Xerolux/IDM-Smart-Climate-Platform/hardware/esp-sensor/manufacturing/B-ES3-C6/IDM-RoomSensor-ESP-B-ES3-C6-top.png

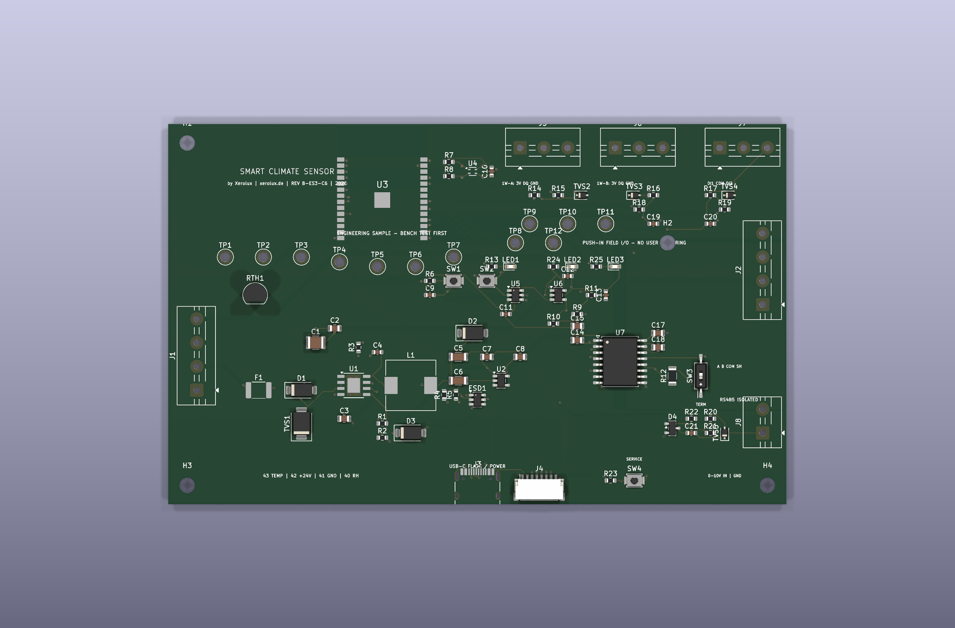
hardware/esp-sensor/manufacturing/B-ES3-C6/IDM-RoomSensor-ESP-B-ES3-C6-top.png
