Xerolux/IDM-Smart-Climate-Platform/hardware/classic-sensor/manufacturing/B-ES1/IDM-RoomSensor-Classic-B-ES1-top.png

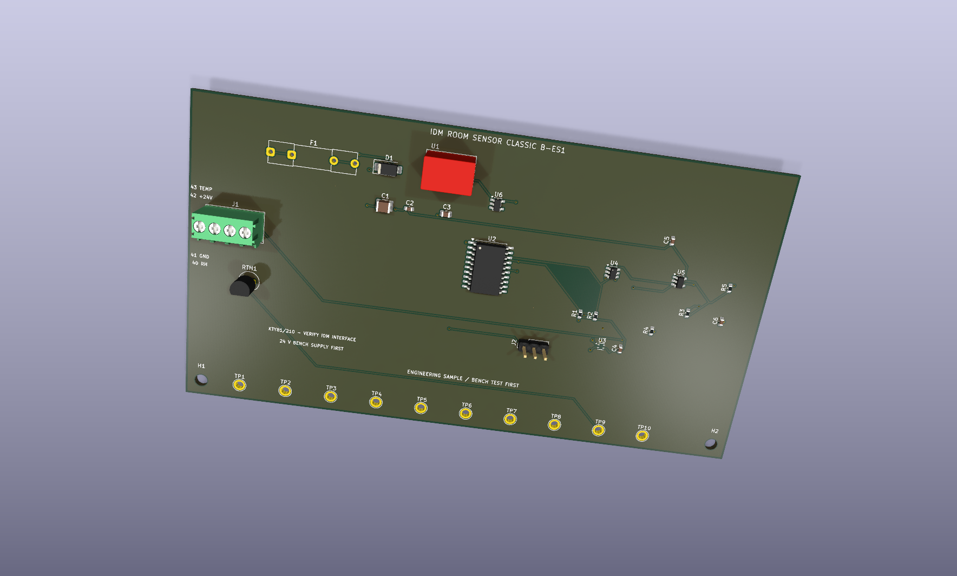
hardware/classic-sensor/manufacturing/B-ES1/IDM-RoomSensor-Classic-B-ES1-top.png
