Xerolux/IDM-Smart-Climate-Platform/hardware/esp-sensor/enclosure/idm-roomsensor-b-es3-c6-preview.png

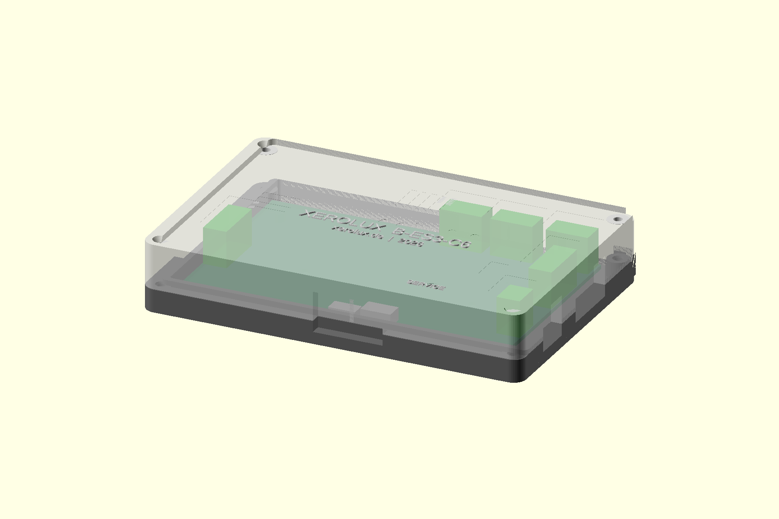
hardware/esp-sensor/enclosure/idm-roomsensor-b-es3-c6-preview.png
