Xerolux/IDM-Smart-Climate-Platform/hardware/esp-sensor/enclosure/idm-roomsensor-b-es4-air-preview.png

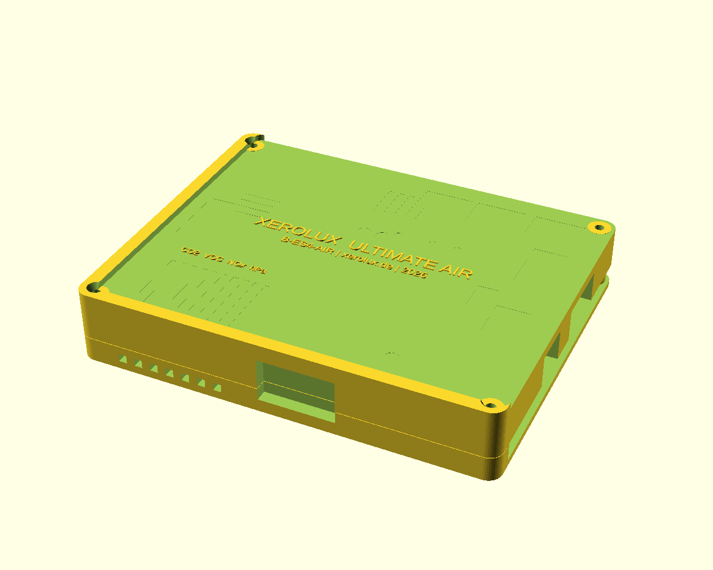
hardware/esp-sensor/enclosure/idm-roomsensor-b-es4-air-preview.png
