Xerolux/IDM-Smart-Climate-Platform/hardware/esp-sensor/enclosure/idm-roomsensor-b-es4-air-r2_S5-print-plate.stl

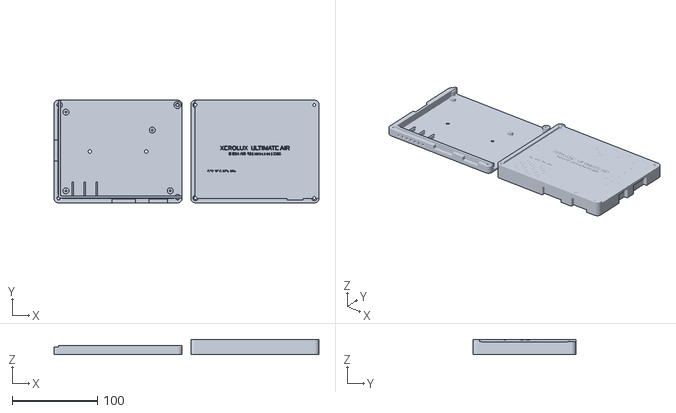
[picture p6: CAD file, 2026-08-08]
hardware/esp-sensor/enclosure/idm-roomsensor-b-es4-air-r2_S5-print-plate.stl
310.0 x 120.0 x 17.9
