Xerolux/IDM-Smart-Climate-Platform/hardware/esp-sensor/manufacturing/B-ES4-AIR-R2/Gehaeuse/idm-roomsensor-b-es4-air-r2_base.stl

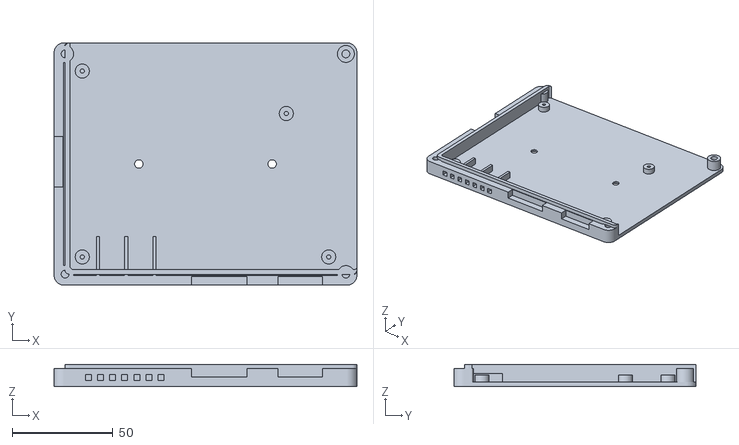
[picture p7: CAD file, 2026-08-08]
hardware/esp-sensor/manufacturing/B-ES4-AIR-R2/Gehaeuse/idm-roomsensor-b-es4-air-r2_base.stl
150.0 x 120.0 x 11.0
