Xerolux/IDM-Smart-Climate-Platform/hardware/esp-sensor/manufacturing/B-ES4-AIR/Gehaeuse/idm-roomsensor-b-es4-air_lid.stl

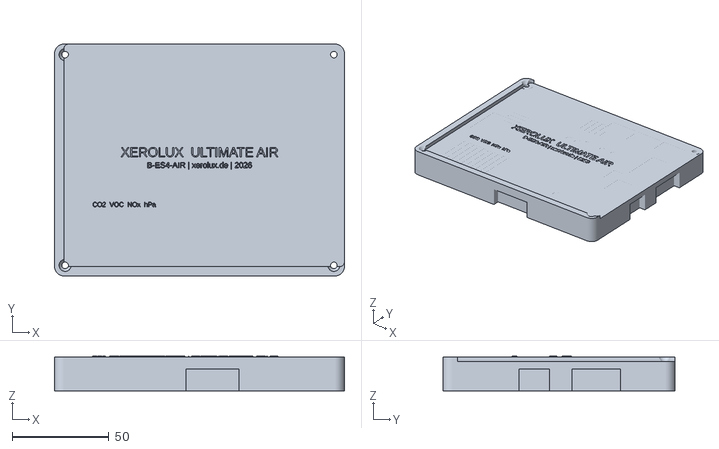
[picture p9: CAD file, 2026-08-07]
hardware/esp-sensor/manufacturing/B-ES4-AIR/Gehaeuse/idm-roomsensor-b-es4-air_lid.stl
150.0 x 120.0 x 17.9
