Xerolux/IDM-Smart-Climate-Platform/hardware/esp-sensor/manufacturing/B-ES5-MODULAR/Gehaeuse/idm-roomsensor-b-es5-modular_S5-print-plate.stl

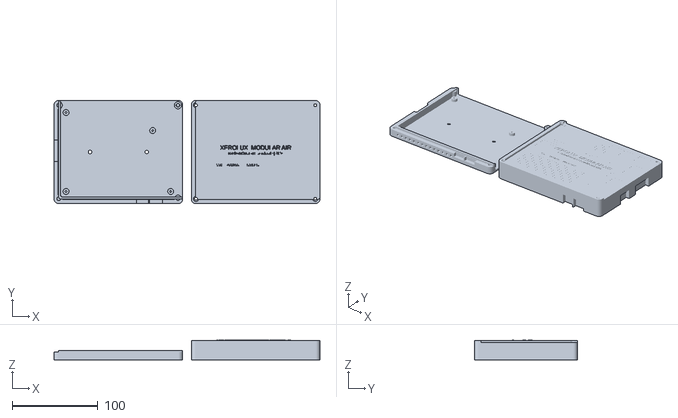
[picture p11: CAD file, 2026-08-07]
hardware/esp-sensor/manufacturing/B-ES5-MODULAR/Gehaeuse/idm-roomsensor-b-es5-modular_S5-print-plate.stl
310.0 x 120.0 x 22.9
