Xerolux/IDM-Smart-Climate-Platform/hardware/esp-sensor/enclosure/idm-roomsensor-b-es3-c6_S5-print-plate.stl

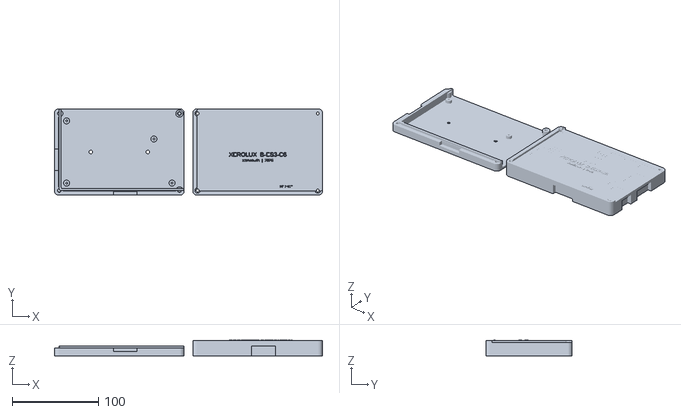
[picture p12: CAD file, 2026-08-07]
hardware/esp-sensor/enclosure/idm-roomsensor-b-es3-c6_S5-print-plate.stl
310.0 x 100.0 x 17.9
