Xerolux/IDM-Smart-Climate-Platform/hardware/esp-sensor/enclosure/idm-roomsensor-b-es3-c6_base.stl

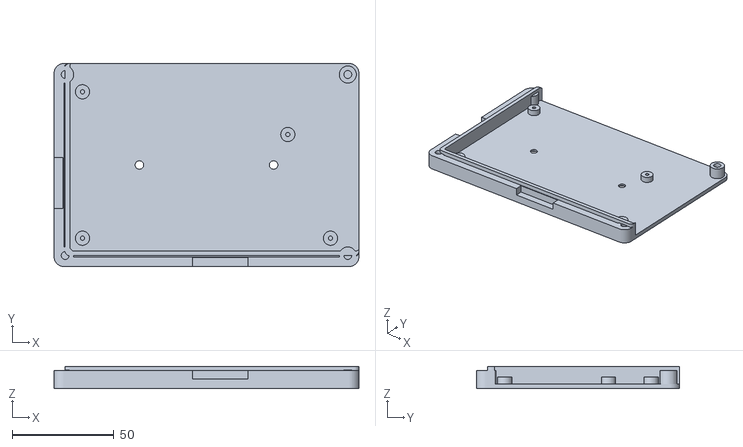
[picture p13: CAD file, 2026-08-07]
hardware/esp-sensor/enclosure/idm-roomsensor-b-es3-c6_base.stl
150.0 x 100.0 x 11.0
