Xerolux/IDM-Smart-Climate-Platform/hardware/esp-sensor/enclosure/idm-roomsensor-b-es3-c6_lid.stl

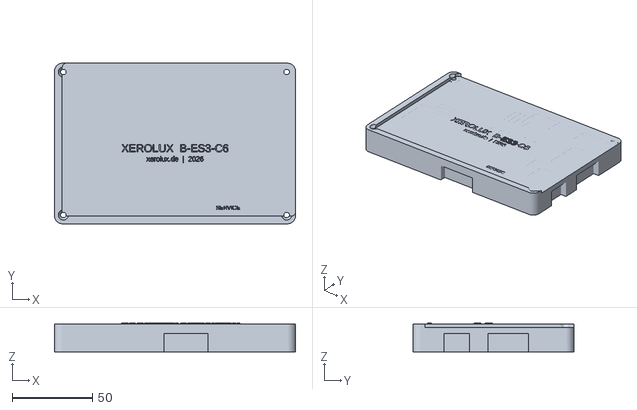
[picture p14: CAD file, 2026-08-07]
hardware/esp-sensor/enclosure/idm-roomsensor-b-es3-c6_lid.stl
150.0 x 100.0 x 17.9
