Xerolux/IDM-Smart-Climate-Platform/hardware/esp-sensor/enclosure/idm-roomsensor-b-es4-air-r2-enclosure.scad

// Xerolux Ultimate Air R2 enclosure variant with relay terminal access.
case_revision_override = "B-ES4-AIR-R2";
relay_output_override = true;
include <idm-roomsensor-b-es4-air-enclosure.scad>;
