Xerolux/IDM-Smart-Climate-Platform/(list of files, cad)

Other CAD files:
hardware/esp-sensor/manufacturing/B-ES4-AIR/Gehaeuse/idm-roomsensor-b-es4-air_S5-print-plate.stl
hardware/esp-sensor/manufacturing/B-ES5-MODULAR/Gehaeuse/idm-roomsensor-b-es5-modular_base.stl
hardware/esp-sensor/manufacturing/B-ES4-AIR/Gehaeuse/idm-roomsensor-b-es4-air_base.stl
hardware/esp-sensor/enclosure/idm-roomsensor-b-es5-modular_base.stl
hardware/esp-sensor/enclosure/idm-roomsensor-b-es4-air_base.stl
hardware/esp-sensor/enclosure/idm-roomsensor-b-es4-air_S5-print-plate.stl
hardware/esp-sensor/enclosure/idm-roomsensor-b-es4-air-enclosure.scad
hardware/esp-sensor/manufacturing/B-ES4-AIR-R2/Gehaeuse/idm-roomsensor-b-es4-air-enclosure.scad
hardware/esp-sensor/manufacturing/B-ES4-AIR/Gehaeuse/idm-roomsensor-b-es4-air-enclosure.scad
