Xerolux/IDM-Smart-Climate-Platform/hardware/classic-sensor/manufacturing/README.md

# Classic sensor manufacturing

`B-ES1/` is released for fabrication as a small-quantity engineering sample.
Use its fabrication ZIP and exact BOM. See `B-ES1/README.md` for assembly and
bring-up constraints.

The JLCPCB files and DRC report in this parent directory belong to the old
incomplete Rev-A design and must not be uploaded.
