Xerolux/IDM-Smart-Climate-Platform/hardware/esp-sensor/manufacturing/B-ES5-MODULAR/Modules/AIR-VOCNOX/README.md

# AIR-VOCNOX / SGP41 order package

Upload `AIR-VOCNOX-fabrication.zip`, then the BOM and CPL in `JLCPCB/`. Select
4 layers, 1.6 mm FR-4, Standard PCBA, double-sided assembly and wave soldering.
U1/C3659325 is the SGP41; do not substitute it. J1/C58378 is the bottom-side
female AIR-SLOT socket and may require pre-ordering. Verify its bottom-side
placement and the SGP41 port orientation in the JLCPCB viewer.
