Xerolux/IDM-Smart-Climate-Platform/hardware/esp-sensor/manufacturing/B-ES2-C6/IDM-RoomSensor-ESP-B-ES2-C6-top.png

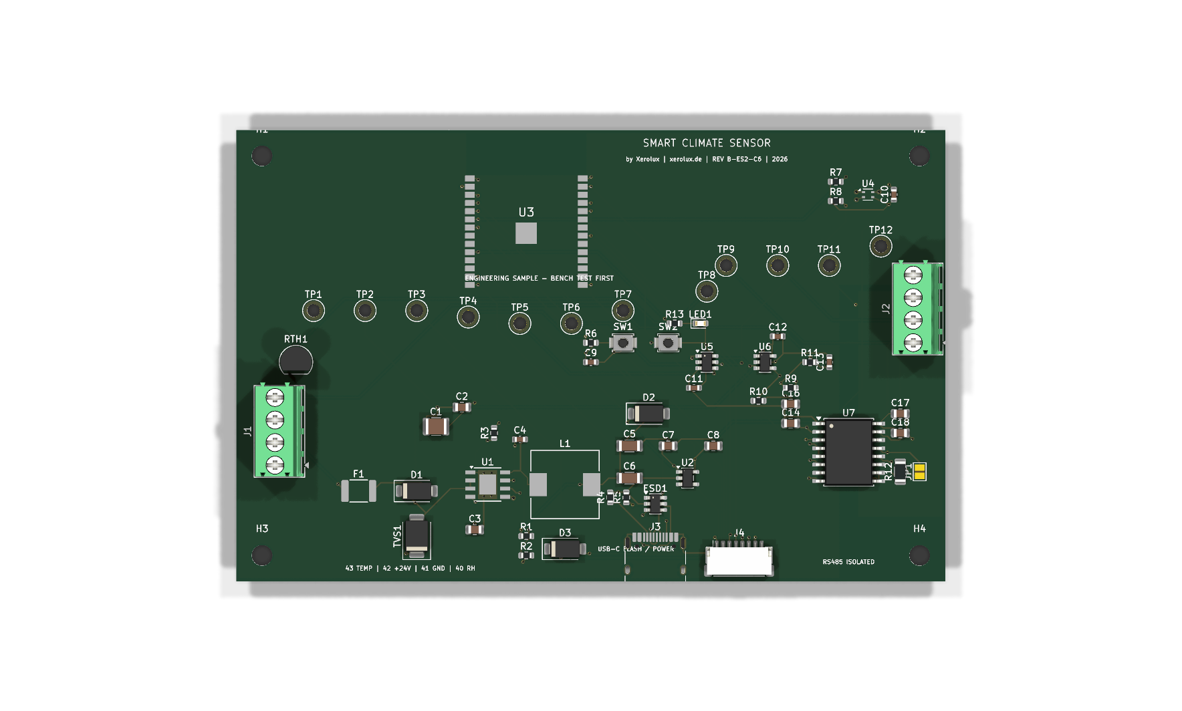
hardware/esp-sensor/manufacturing/B-ES2-C6/IDM-RoomSensor-ESP-B-ES2-C6-top.png
