Xerolux/IDM-Smart-Climate-Platform/hardware/esp-sensor/manufacturing/B-ES4-AIR-R2/IDM-RoomSensor-ESP-B-ES4-AIR-R2-top.png

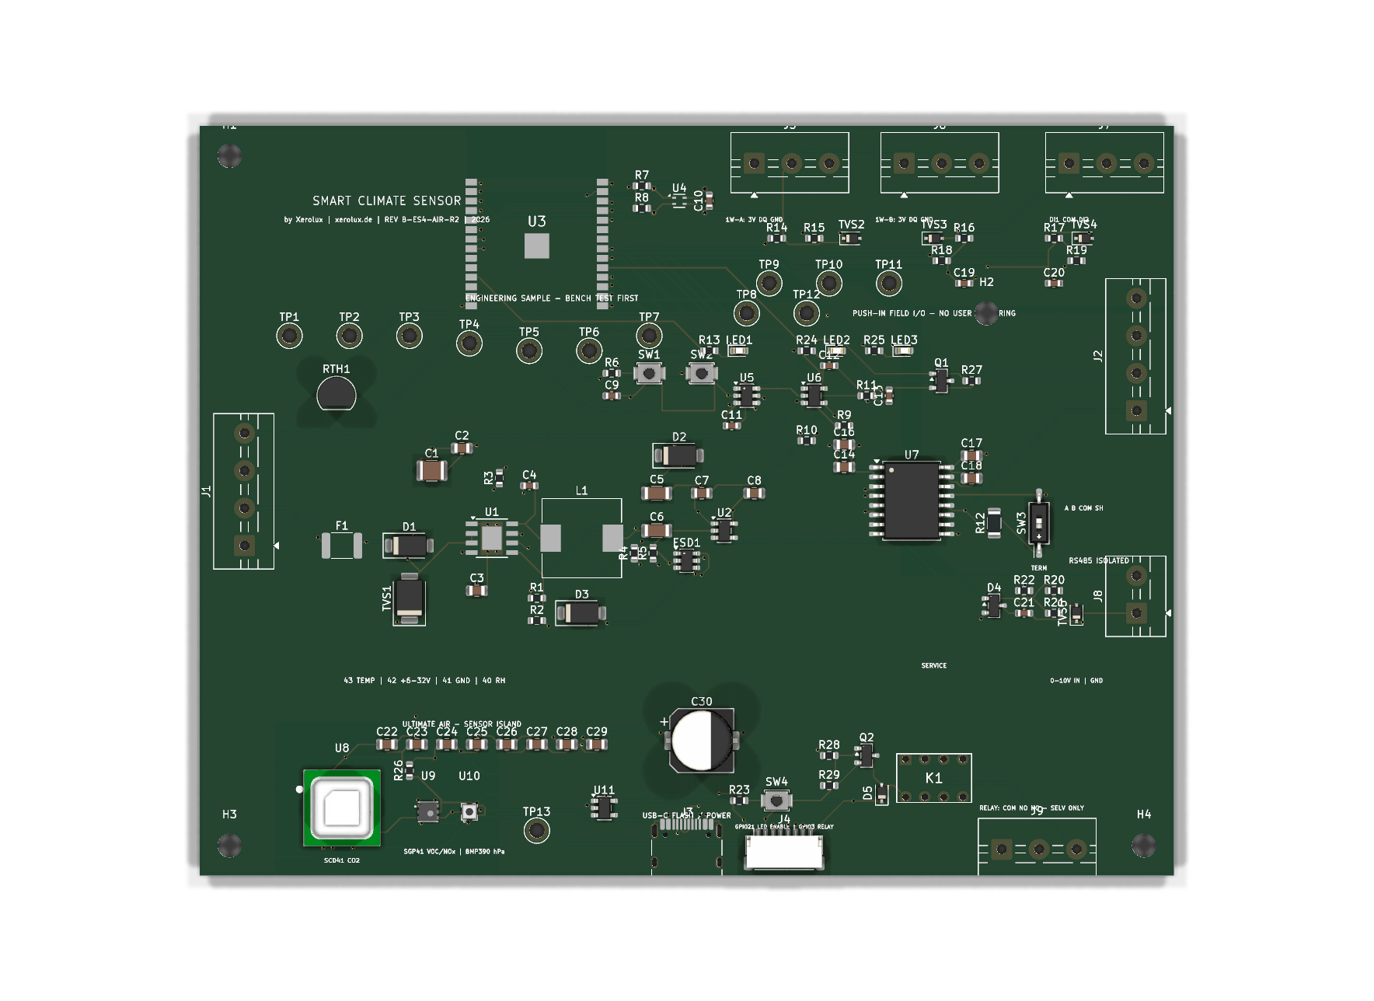
hardware/esp-sensor/manufacturing/B-ES4-AIR-R2/IDM-RoomSensor-ESP-B-ES4-AIR-R2-top.png
