Xerolux/IDM-Smart-Climate-Platform/hardware/esp-sensor/manufacturing/B-ES4-AIR/IDM-RoomSensor-ESP-B-ES4-AIR-top.png

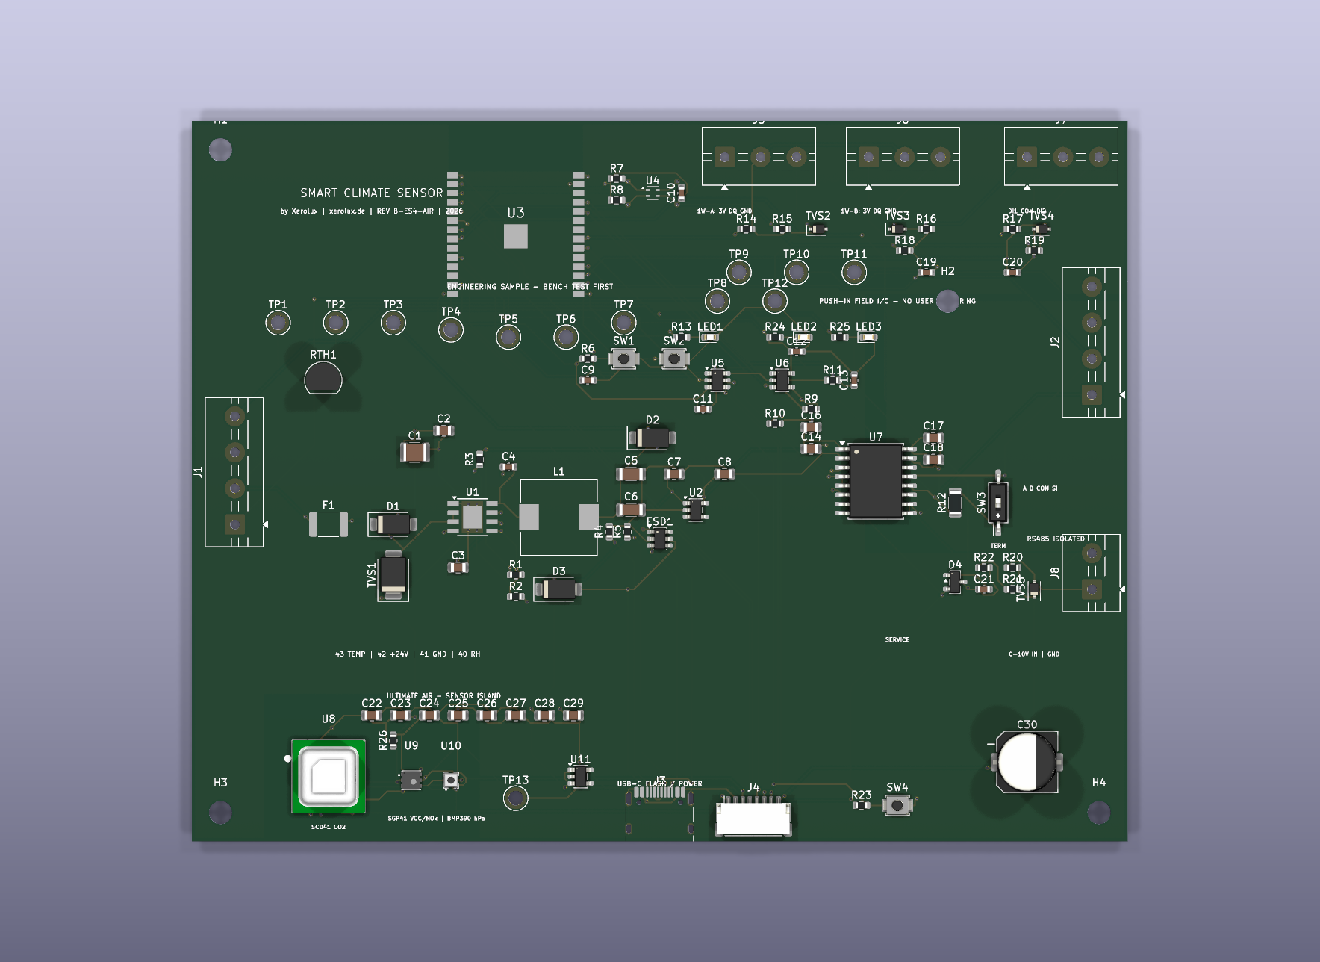
hardware/esp-sensor/manufacturing/B-ES4-AIR/IDM-RoomSensor-ESP-B-ES4-AIR-top.png
