Xerolux/IDM-Smart-Climate-Platform/hardware/esp-sensor/manufacturing/B-ES5-MODULAR/IDM-RoomSensor-ESP-B-ES5-MODULAR-top.png

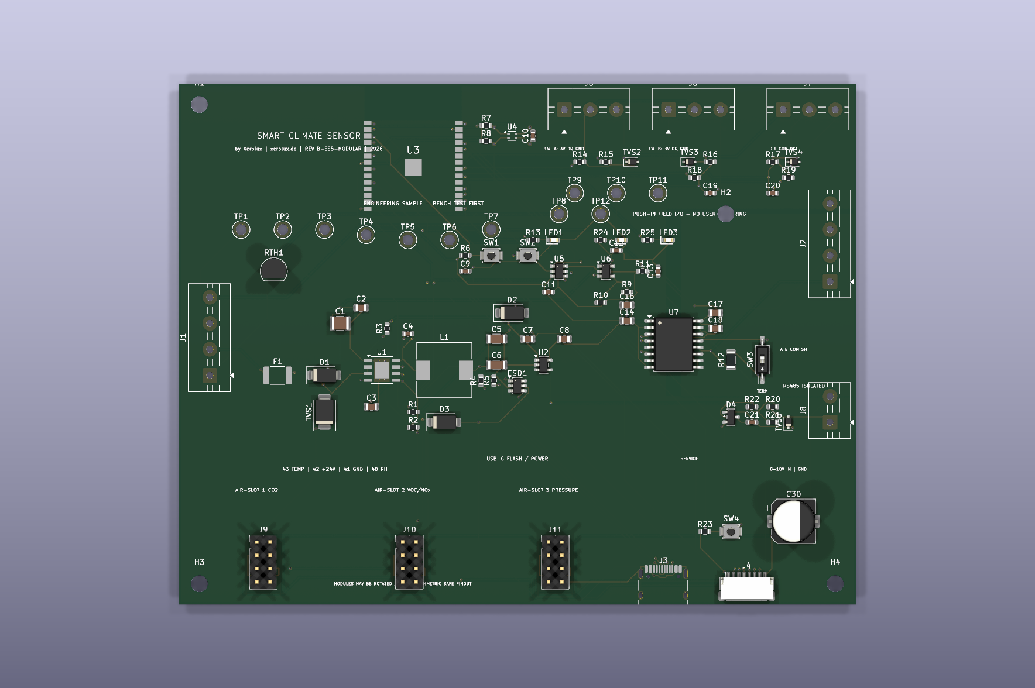
hardware/esp-sensor/manufacturing/B-ES5-MODULAR/IDM-RoomSensor-ESP-B-ES5-MODULAR-top.png
