Xerolux/IDM-Smart-Climate-Platform/hardware/esp-sensor/manufacturing/B-ES5-MODULAR/Modules/AIR-CO2/AIR-CO2-top.png

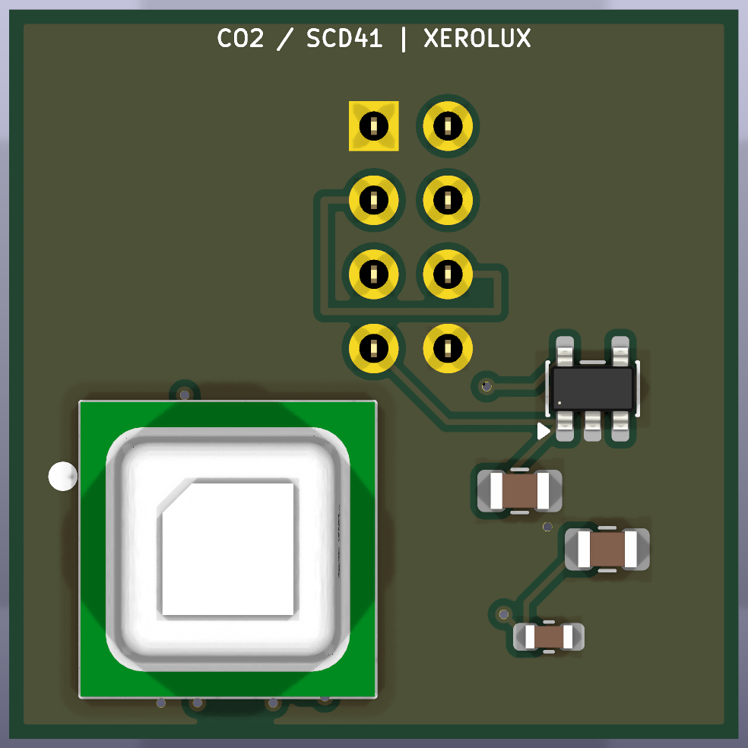
hardware/esp-sensor/manufacturing/B-ES5-MODULAR/Modules/AIR-CO2/AIR-CO2-top.png
