Xerolux/IDM-Smart-Climate-Platform/hardware/esp-sensor/manufacturing/B-ES5-MODULAR/Modules/AIR-PRESSURE/AIR-PRESSURE-top.png

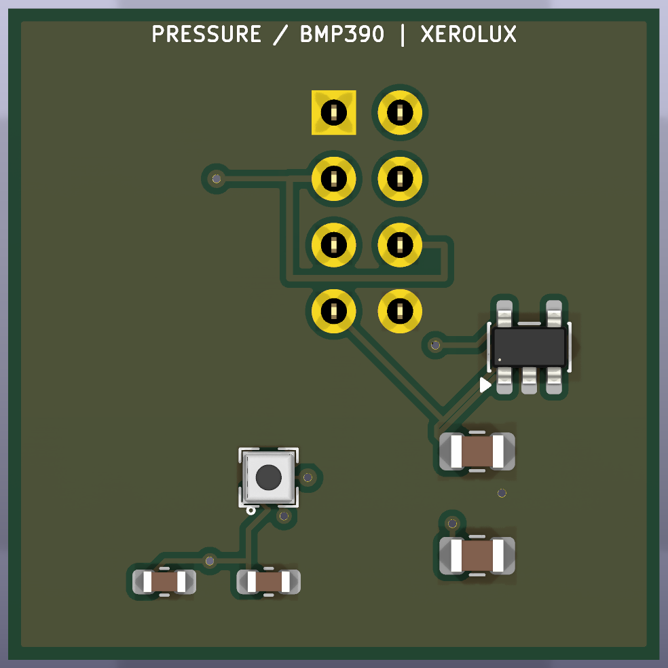
hardware/esp-sensor/manufacturing/B-ES5-MODULAR/Modules/AIR-PRESSURE/AIR-PRESSURE-top.png
