Xerolux/IDM-Smart-Climate-Platform/hardware/esp-sensor/manufacturing/B-ES5-MODULAR/Modules/AIR-VOCNOX/AIR-VOCNOX-top.png

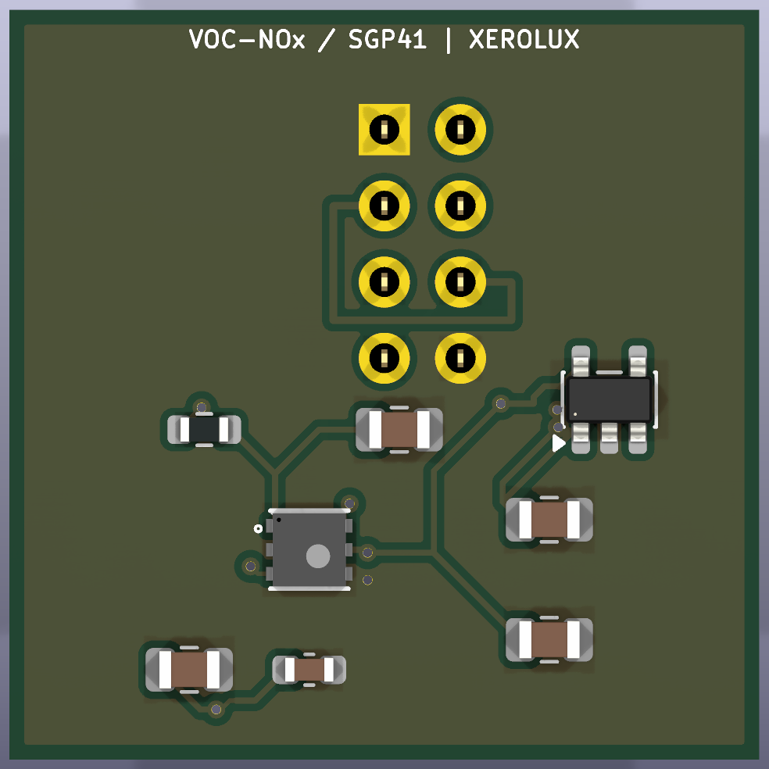
hardware/esp-sensor/manufacturing/B-ES5-MODULAR/Modules/AIR-VOCNOX/AIR-VOCNOX-top.png
