Xerolux/IDM-Smart-Climate-Platform/hardware/esp-sensor/enclosure/B-ES4-AIR-S5-VALIDATION.md

# B-ES4-AIR enclosure validation

Status: CAD and STL mesh checked; a physical first article remains mandatory.

- Base mesh: manifold, 150 x 120 x 11 mm
- Lid mesh: manifold, 150 x 120 x 17.95 mm including raised labels
- Combined plate: manifold, 310 x 120 mm
- S5 bed fit: passed with 5 mm brim on 330 x 240 mm
- PCB: 130 x 100 mm on four dedicated standoffs
- tallest push-in terminal model: 14.4 mm above PCB
- internal PCB-to-roof clearance: approximately 16.7 mm
- separate low intake and roof slots for AIR sensor exchange

Before release, verify the printed enclosure with an assembled PCB: all
terminal openings, USB-C, J4, buttons, LEDs, SW3, screw bosses, ventilation,
C30 height and sensor clearances.
