Xerolux/IDM-Smart-Climate-Platform/hardware/esp-sensor/manufacturing/B-ES4-AIR-R2/RELEASE-VERIFICATION.md

# B-ES4-AIR-R2 first-article verification

- [ ] Visual inspection, polarity and placement approved
- [ ] No shorts on VIN, SYS_5V, 3V3, AIR_3V3 or isolated RS485 rails
- [ ] USB-C powers and programs the board
- [ ] 6 V, 12 V, 24 V and 32 VDC power tests passed
- [ ] USB-C and external DC connected simultaneously without backfeed/overheat
- [ ] Status, bus and VIN LEDs individually switch and remain off after reboot
- [ ] Relay defaults off and COM/NO/NC continuity matches firmware state
- [ ] Relay tested only with SELV/signalling load within its qualified rating
- [ ] SHT45, SCD41, SGP41 and BMP388 readings plausible
- [ ] RS-485 isolation, polarity and termination verified
- [ ] 0-10 V input calibrated and protected-path test passed
- [ ] 0-10 V output calibrated across the intended load range
- [ ] Both contact inputs and up to four DS18B20 probes tested
- [ ] Enclosure openings, ventilation, buttons, LEDs and relay clearance fit
- [ ] 24-hour thermal and stability test passed before HVAC connection
