Xerolux/IDM-Smart-Climate-Platform/hardware/esp-sensor/manufacturing/B-ES4-AIR-R2/IDM-RoomSensor-ESP-B-ES4-AIR-R2-schematic.pdf

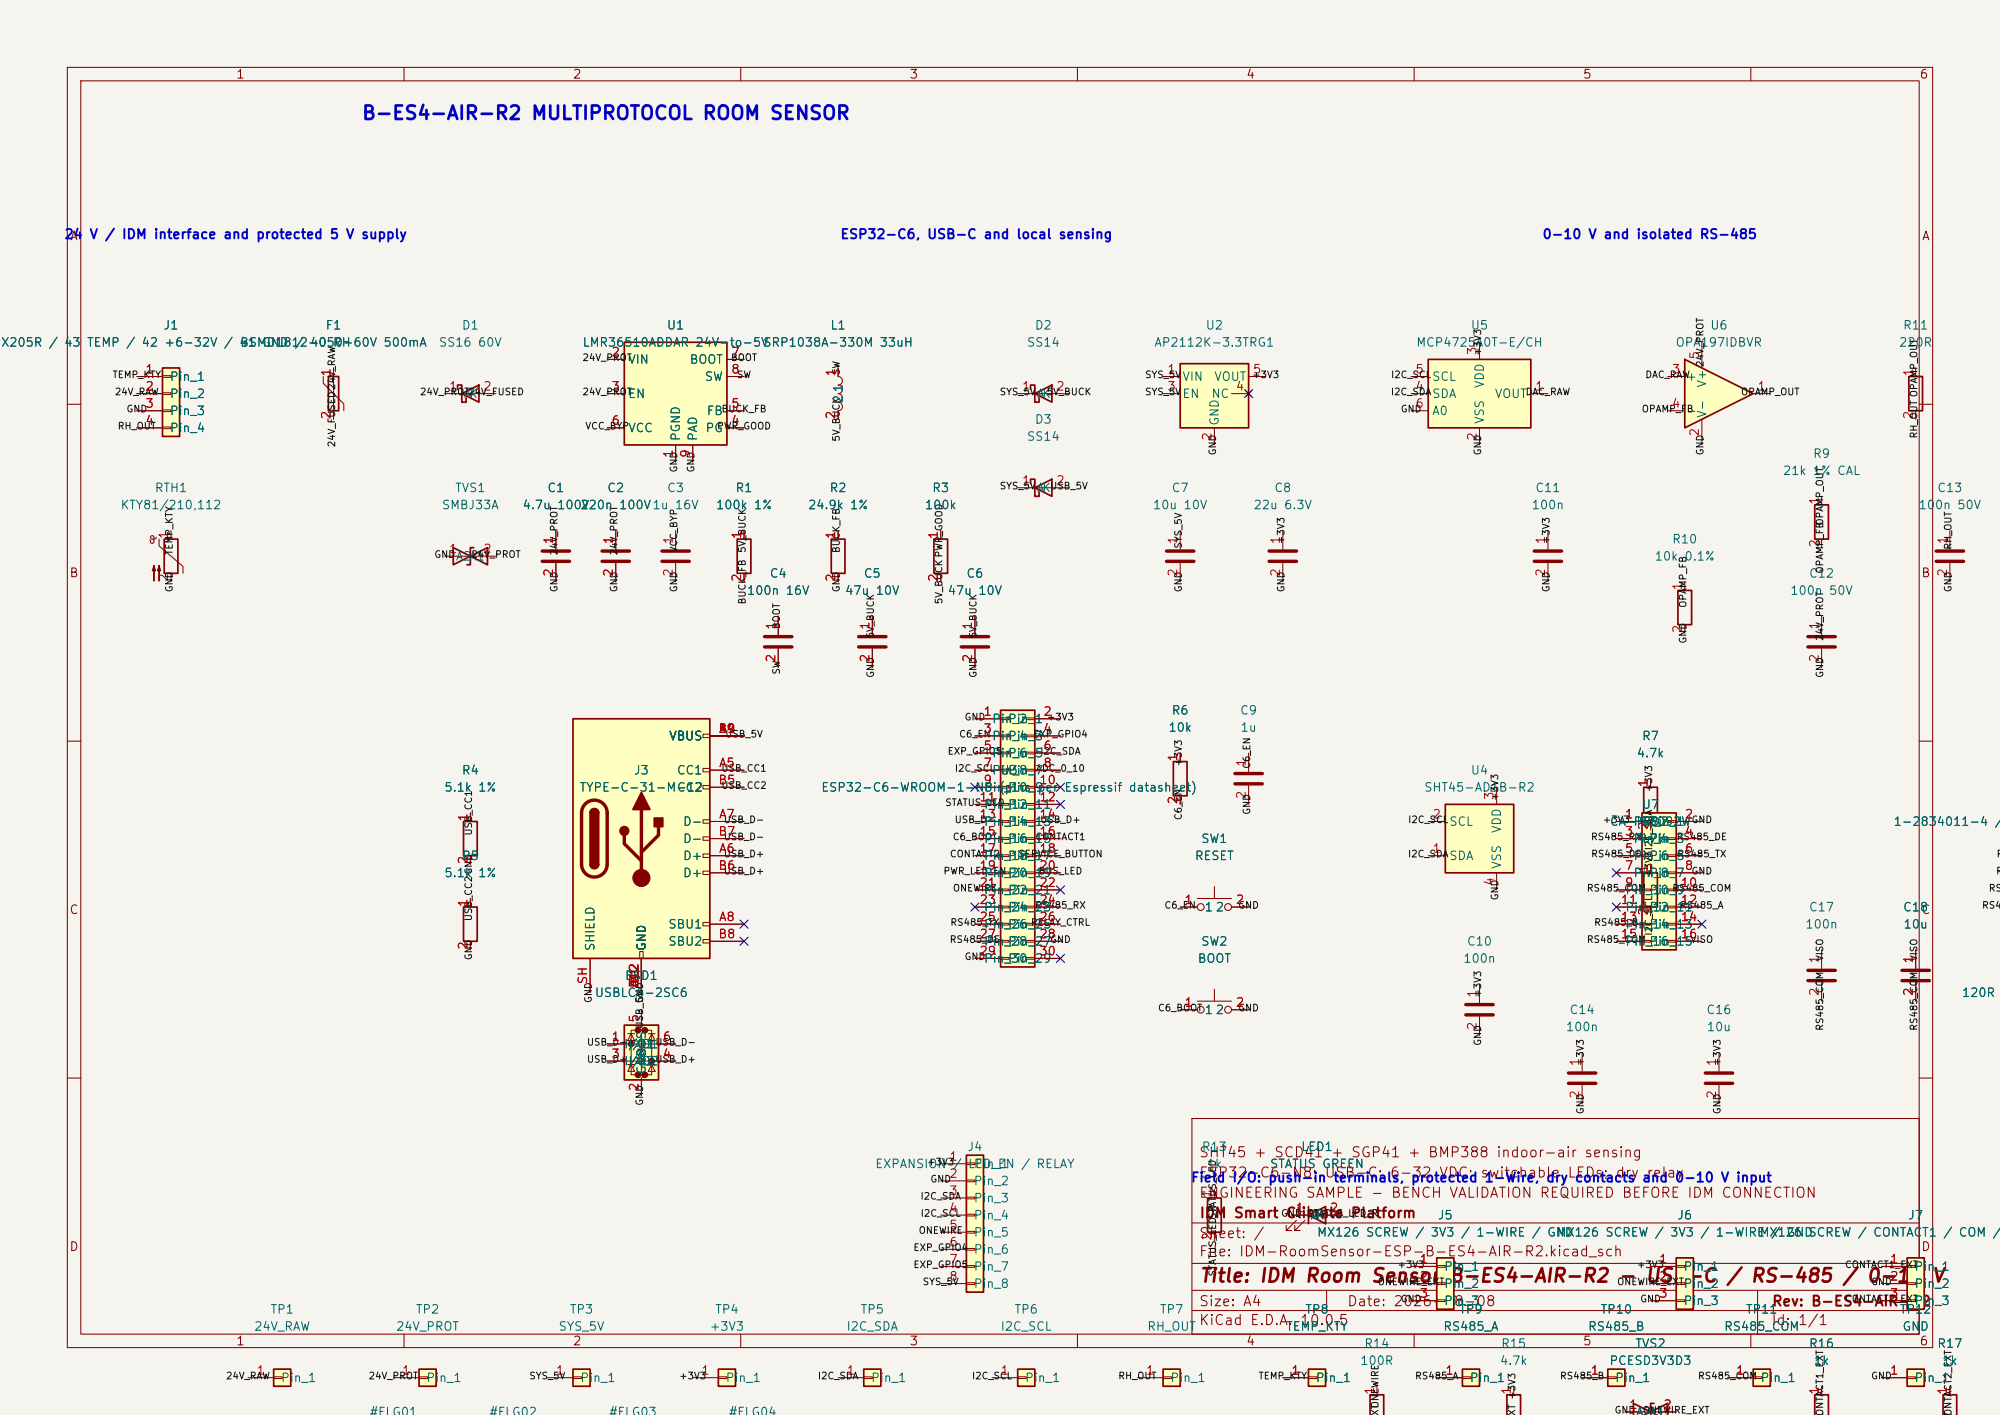
[picture p22: page 1]

B-ES4-AIR-R2 MULTIPROTOCOL ROOM SENSOR

SHT45 + SCD41 + SGP41 + BMP388 indoor-air sensing
ESP32-C6-N8; USB-C; 6-32 VDC; switchable LEDs; dry relay
Field I/O: push-in terminals, protected 1-Wire, dry contacts and 0-10 V input
ENGINEERING SAMPLE - BENCH VALIDATION REQUIRED BEFORE IDM CONNECTION
IDM Smart Climate Platform
Sheet: /
File: IDM-RoomSensor-ESP-B-ES4-AIR-R2.kicad_sch
Title: IDM Room Sensor B-ES4-AIR-R2 - USB-C / RS-485 / 0-10 V
