Xerolux/IDM-Smart-Climate-Platform/hardware/esp-sensor/manufacturing/B-ES5-MODULAR/IDM-RoomSensor-ESP-B-ES5-MODULAR-schematic.pdf

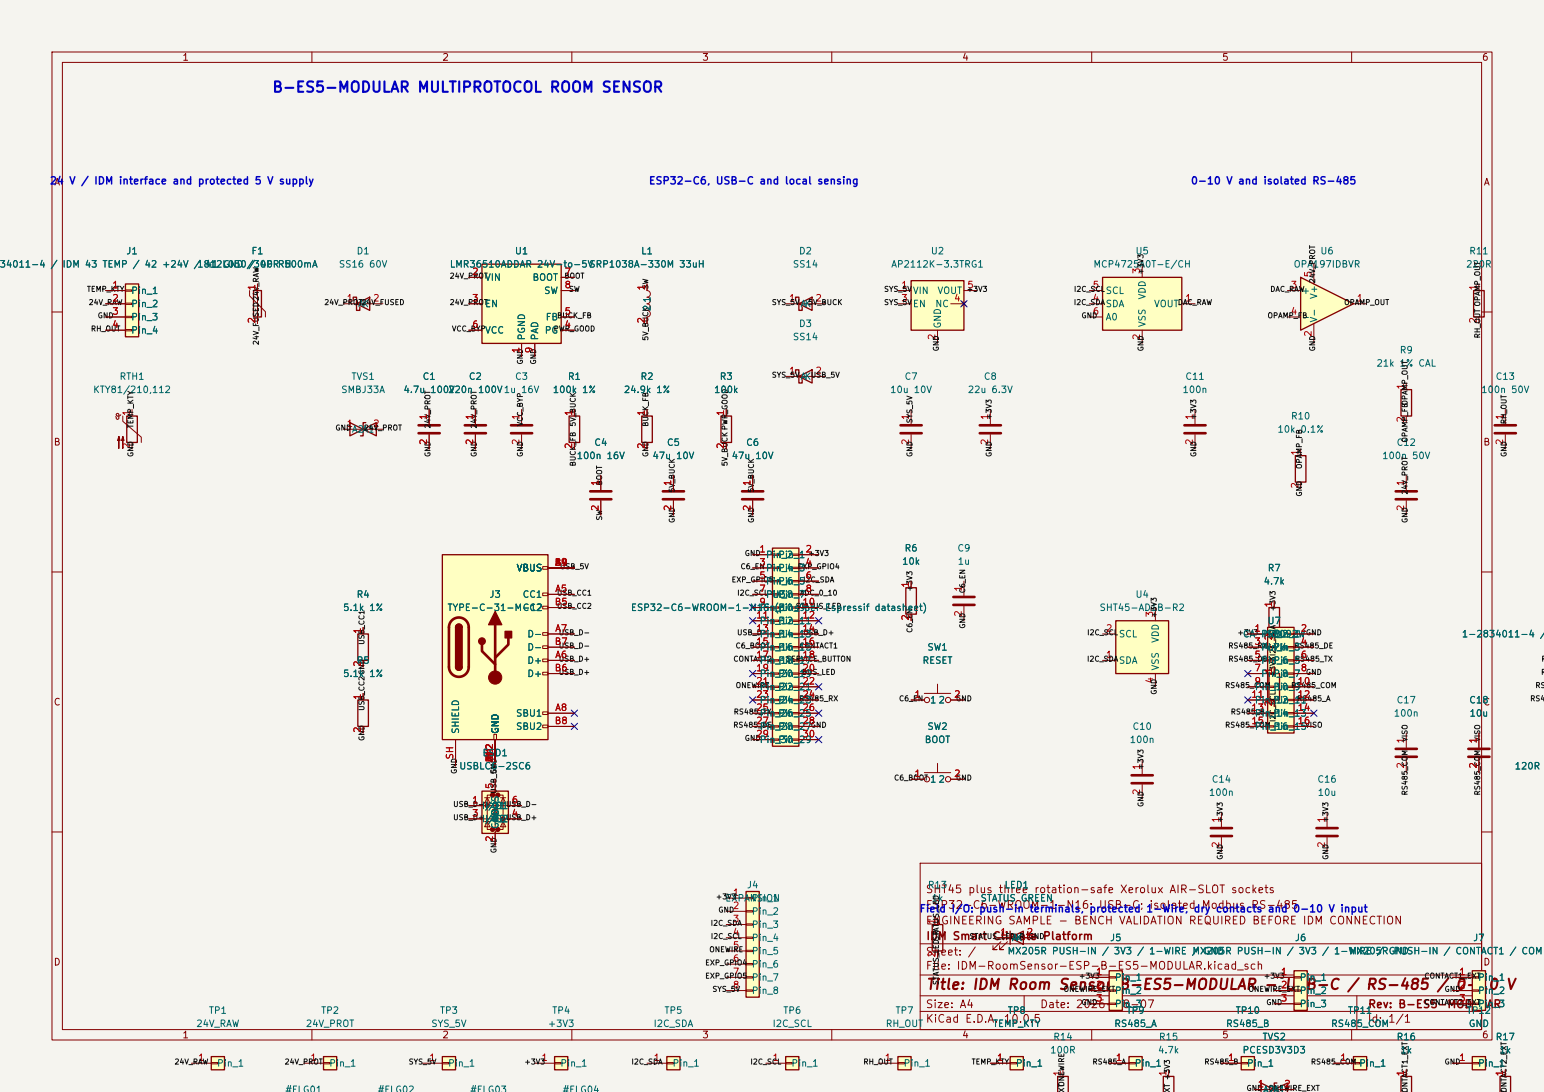
[picture p23: page 1]

B-ES5-MODULAR MULTIPROTOCOL ROOM SENSOR

1-2834011-4 / IDM 43 TEMP / 42 +24V / 41 GND / 40 RH

220u 10V AIR-SLOT reservoir GND A1

SHT45 plus three rotation-safe Xerolux AIR-SLOT sockets
ESP32-C6-WROOM-1-N16; USB-C; isolated Modbus RS-485

LED1
1k Pin_1 1
Field I/O: push-in terminals, protected 1-Wire, dry contacts and 0-10 V input
ENGINEERING SAMPLE - BENCH VALIDATION REQUIRED BEFORE IDM CONNECTION
IDM Smart Climate Platform
Sheet: /
File: IDM-RoomSensor-ESP-B-ES5-MODULAR.kicad_sch
Title: IDM Room Sensor B-ES5-MODULAR - USB-C / RS-485 / 0-10 V

J5 MX205R PUSH-IN / 3V3 / 1-WIRE / GND

J6 MX205R PUSH-IN / 3V3 / 1-WIRE / GND
