Xerolux/IDM-Smart-Climate-Platform/hardware/esp-sensor/manufacturing/B-ES4-AIR/IDM-RoomSensor-ESP-B-ES4-AIR-schematic.pdf

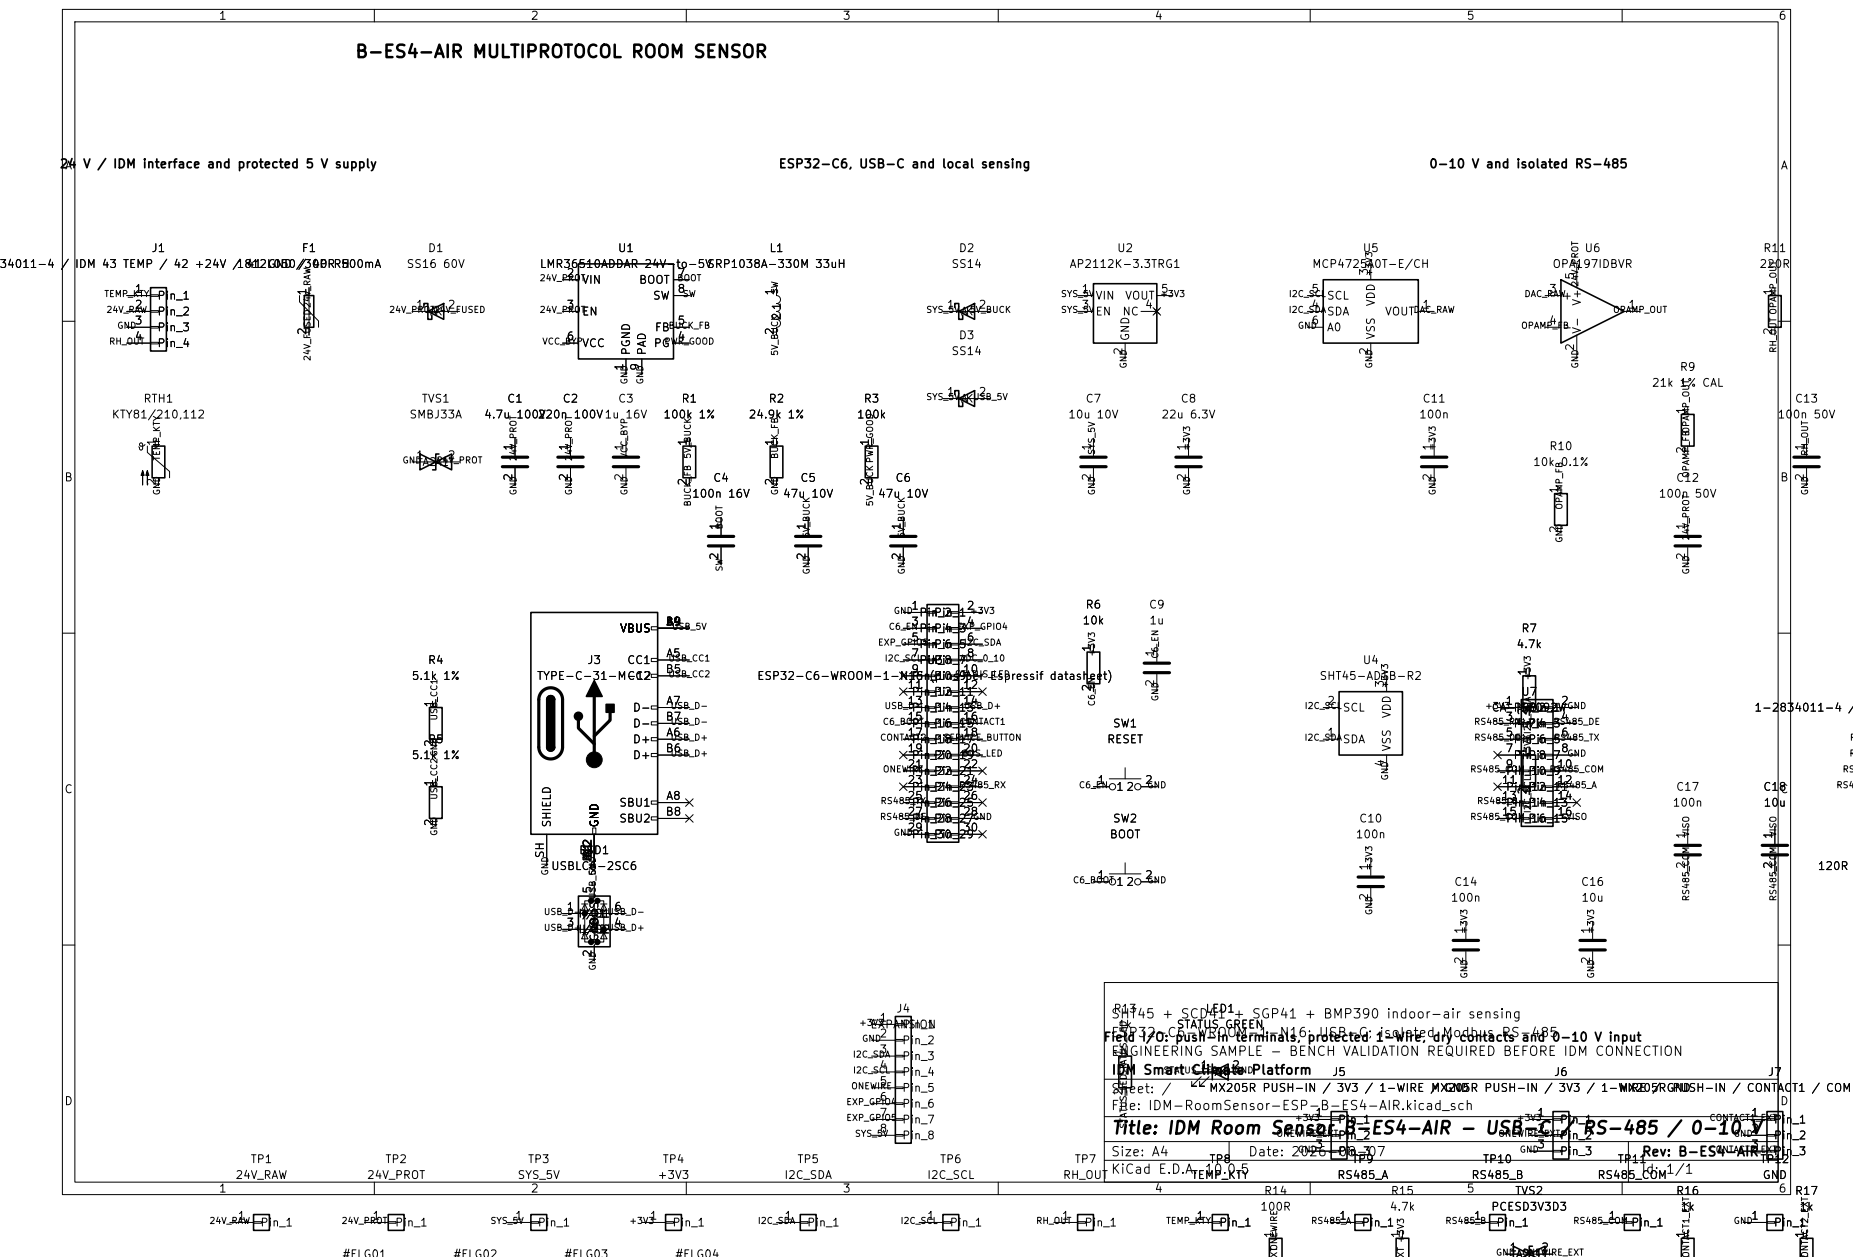
[picture p24: page 1]

B-ES4-AIR MULTIPROTOCOL ROOM SENSOR

1-2834011-4 / IDM 43 TEMP / 42 +24V / 41 GND / 40 RH

SHT45 + SCD41 + SGP41 + BMP390 indoor-air sensing
ESP32-C6-WROOM-1-N16; USB-C; isolated Modbus RS-485
Field I/O: push-in terminals, protected 1-Wire, dry contacts and 0-10 V input
ENGINEERING SAMPLE - BENCH VALIDATION REQUIRED BEFORE IDM CONNECTION
IDM Smart Climate Platform
Sheet: /
File: IDM-RoomSensor-ESP-B-ES4-AIR.kicad_sch

J5 MX205R PUSH-IN / 3V3 / 1-WIRE / GND

J6 MX205R PUSH-IN / 3V3 / 1-WIRE / GND

TEMP_KTY Title: IDM Room Sensor B-ES4-AIR - USB-C / RS-485 / 0-10 V | Pin_1 1 Pin_2 2 Pin_3 3 | Pin_1 1 Pin_2 2 Pin_3 3

Size: A4 | GND | | Rev: B-ES4-AIR
TP9 RS485_A TP10 RS485_B TP10 RS485_B TP11 RS485_COM TP11 RS485_COM KiCad E.D.A. 10.0.5 | | | Id: 1/1
