Xerolux/IDM-Smart-Climate-Platform/hardware/esp-sensor/manufacturing/B-ES3-C6/IDM-RoomSensor-ESP-B-ES3-C6-schematic.pdf

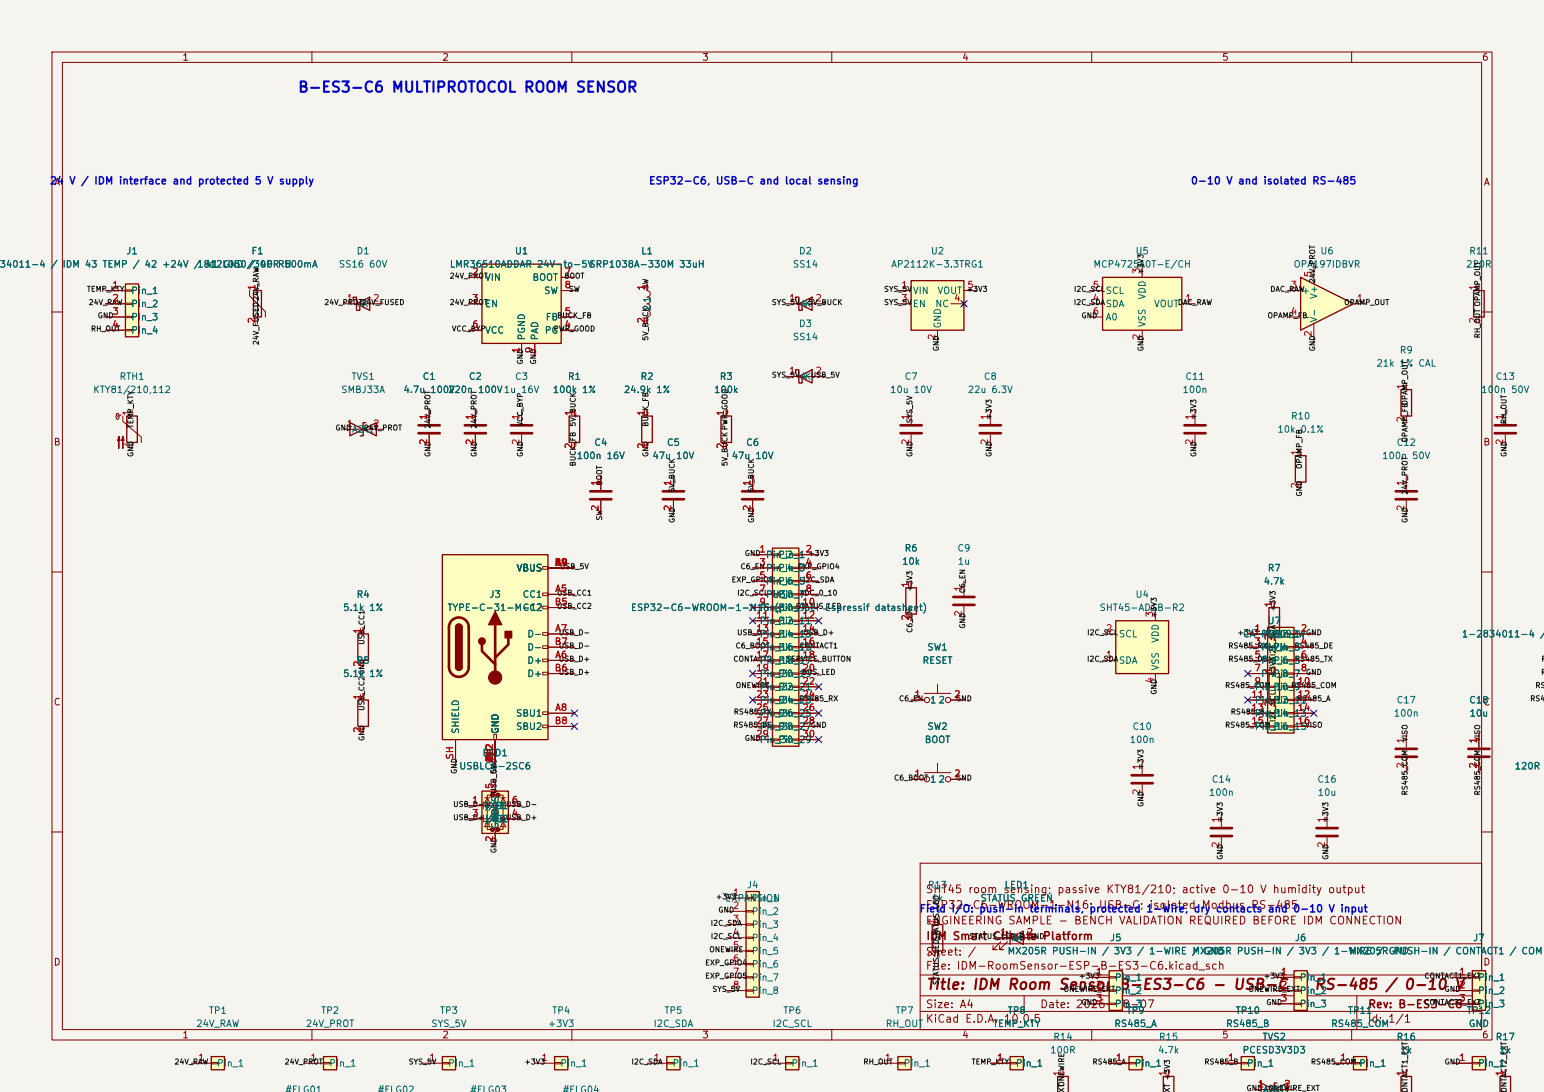
[picture p25: page 1]

24 V / IDM interface and protected 5 V supply

ESP32-C6, USB-C and local sensing

1-2834011-4 / IDM 43 TEMP / 42 +24V / 41 GND / 40 RH

SHT45 room sensing; passive KTY81/210; active 0-10 V humidity output 1 2 C4

ESP32-C6-WROOM-1-N16; USB-C; isolated Modbus RS-485
Field I/O: push-in terminals, protected 1-Wire, dry contacts and 0-10 V input
ENGINEERING SAMPLE - BENCH VALIDATION REQUIRED BEFORE IDM CONNECTION
IDM Smart Climate Platform
Sheet: /
File: IDM-RoomSensor-ESP-B-ES3-C6.kicad_sch

J5 MX205R PUSH-IN / 3V3 / 1-WIRE / GND

J6 MX205R PUSH-IN / 3V3 / 1-WIRE / GND

TEMP_KTY Title: IDM Room Sensor B-ES3-C6 - USB-C / RS-485 / 0-10 V | Pin_1 1 Pin_2 2 Pin_3 3 | Pin_1 1 Pin_2 2 Pin_3 3 | CONTACT1_EXT GND | Pin_1 1 Pin_2 2 Pin_3 3

Size: A4 | | | | | Rev: B-ES3-C6
TP10 RS485_B TP10 RS485_B TP11 RS485_COM TP11 RS485_COM KiCad E.D.A. 10.0.5 | | | | | Id: 1/1
