Xerolux/IDM-Smart-Climate-Platform/hardware/esp-sensor/manufacturing/B-ES2-C6/IDM-RoomSensor-ESP-B-ES2-C6-schematic.pdf

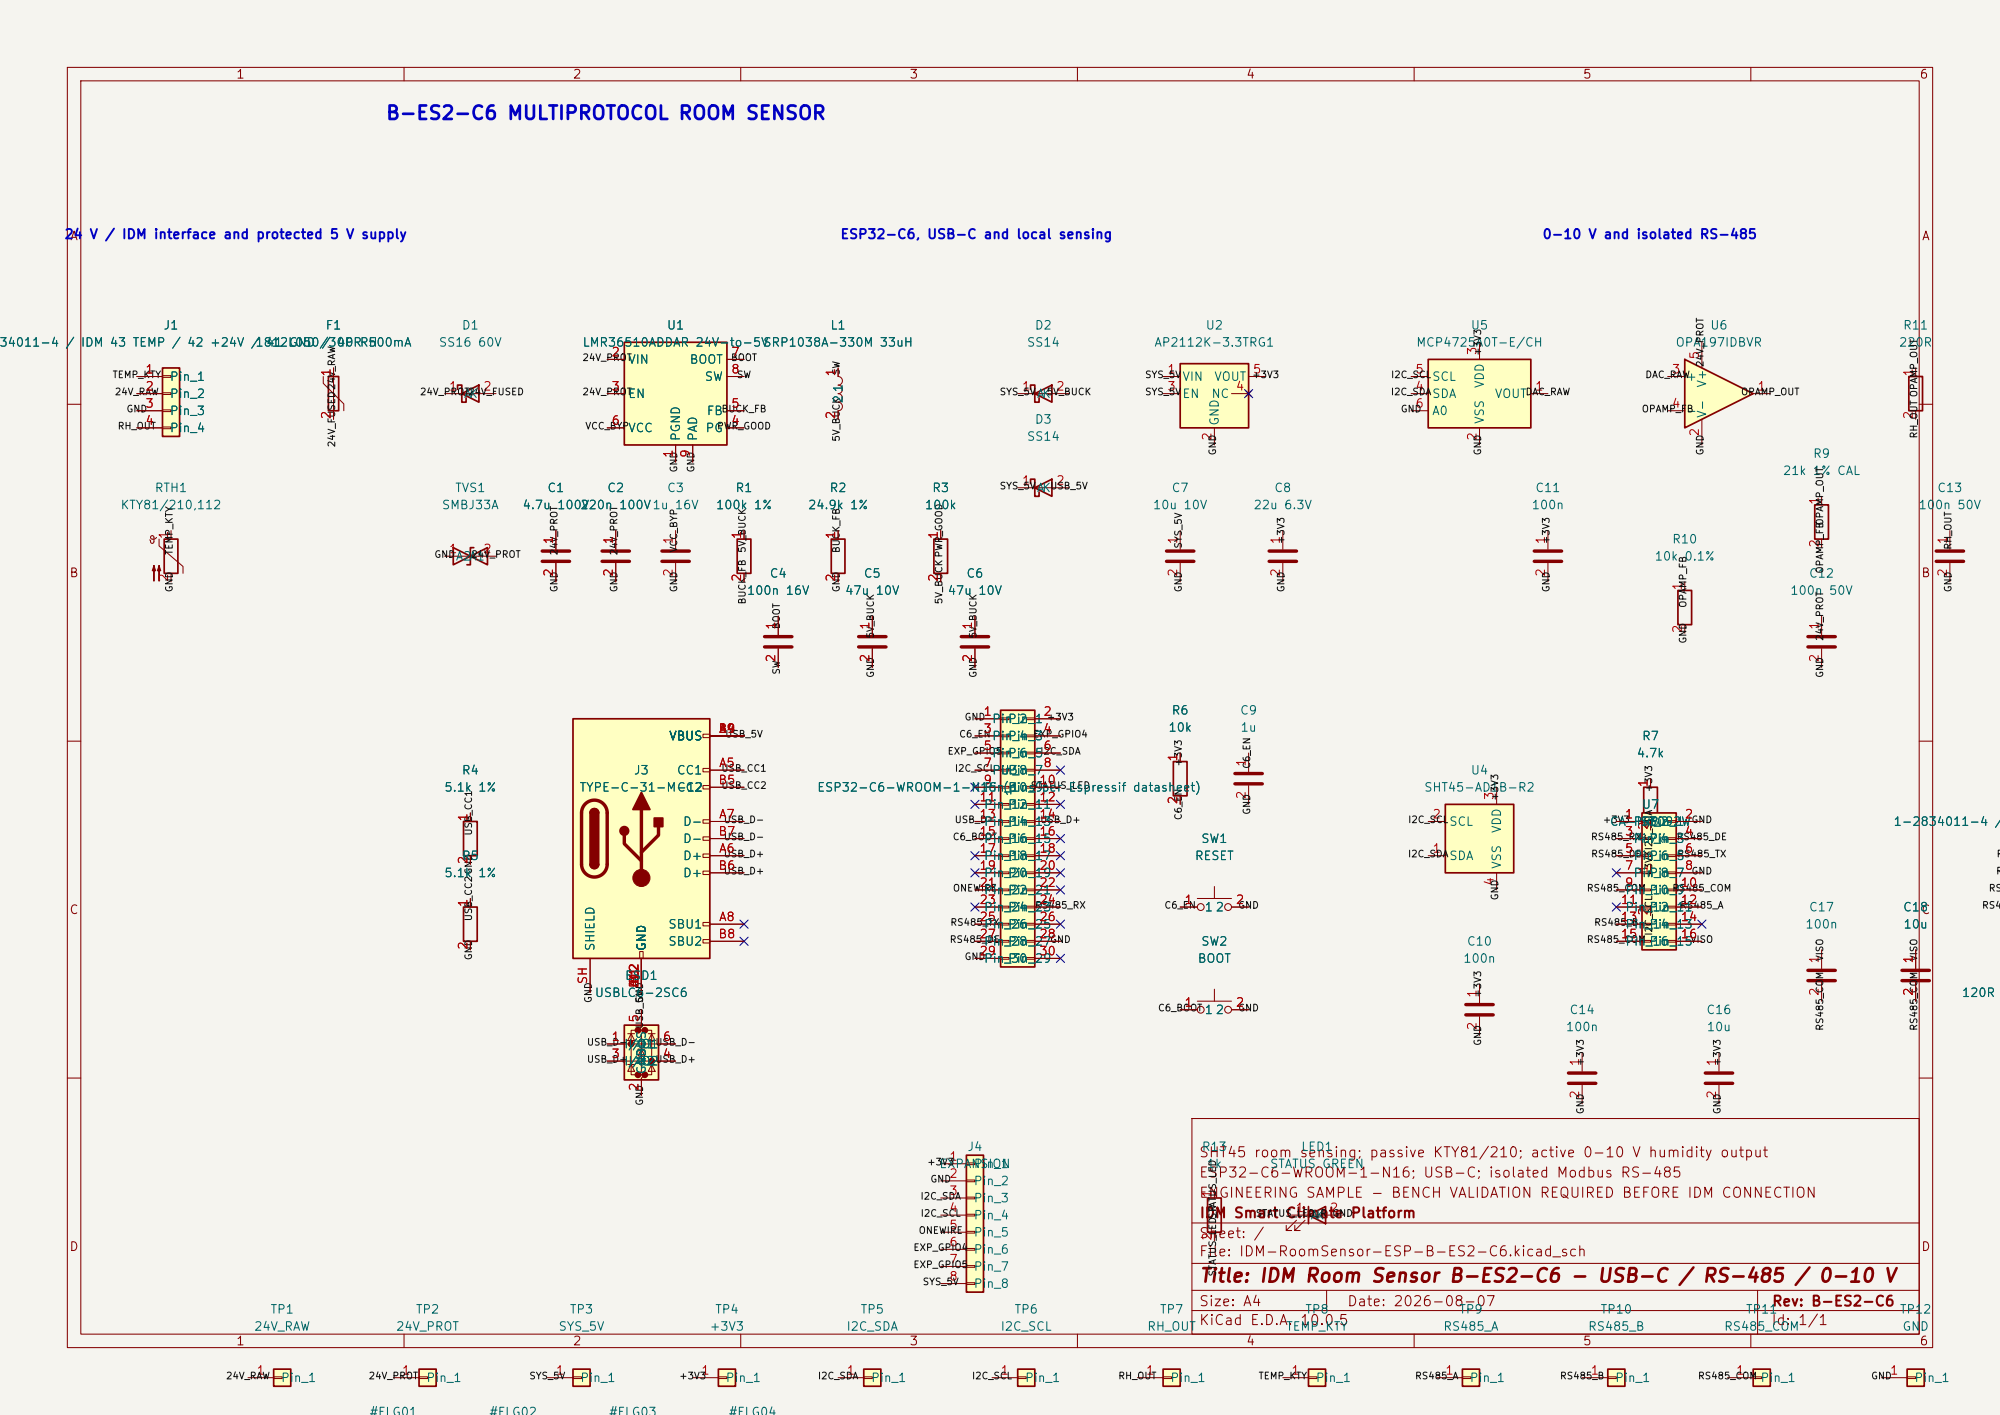
[picture p26: page 1]

1-2834011-4 / IDM 43 TEMP / 42 +24V / 41 GND / 40 RH

ESP32-C6-WROOM-1-N16; USB-C; isolated Modbus RS-485
ENGINEERING SAMPLE - BENCH VALIDATION REQUIRED BEFORE IDM CONNECTION
IDM Smart Climate Platform
Sheet: /
File: IDM-RoomSensor-ESP-B-ES2-C6.kicad_sch
Title: IDM Room Sensor B-ES2-C6 - USB-C / RS-485 / 0-10 V

Size: A4 | Rev: B-ES2-C6
TP10 RS485_B TP11 RS485_COM KiCad E.D.A. 10.0.5 | Id: 1/1
