Xerolux/IDM-Smart-Climate-Platform/hardware/classic-sensor/manufacturing/B-ES1/schematic.pdf

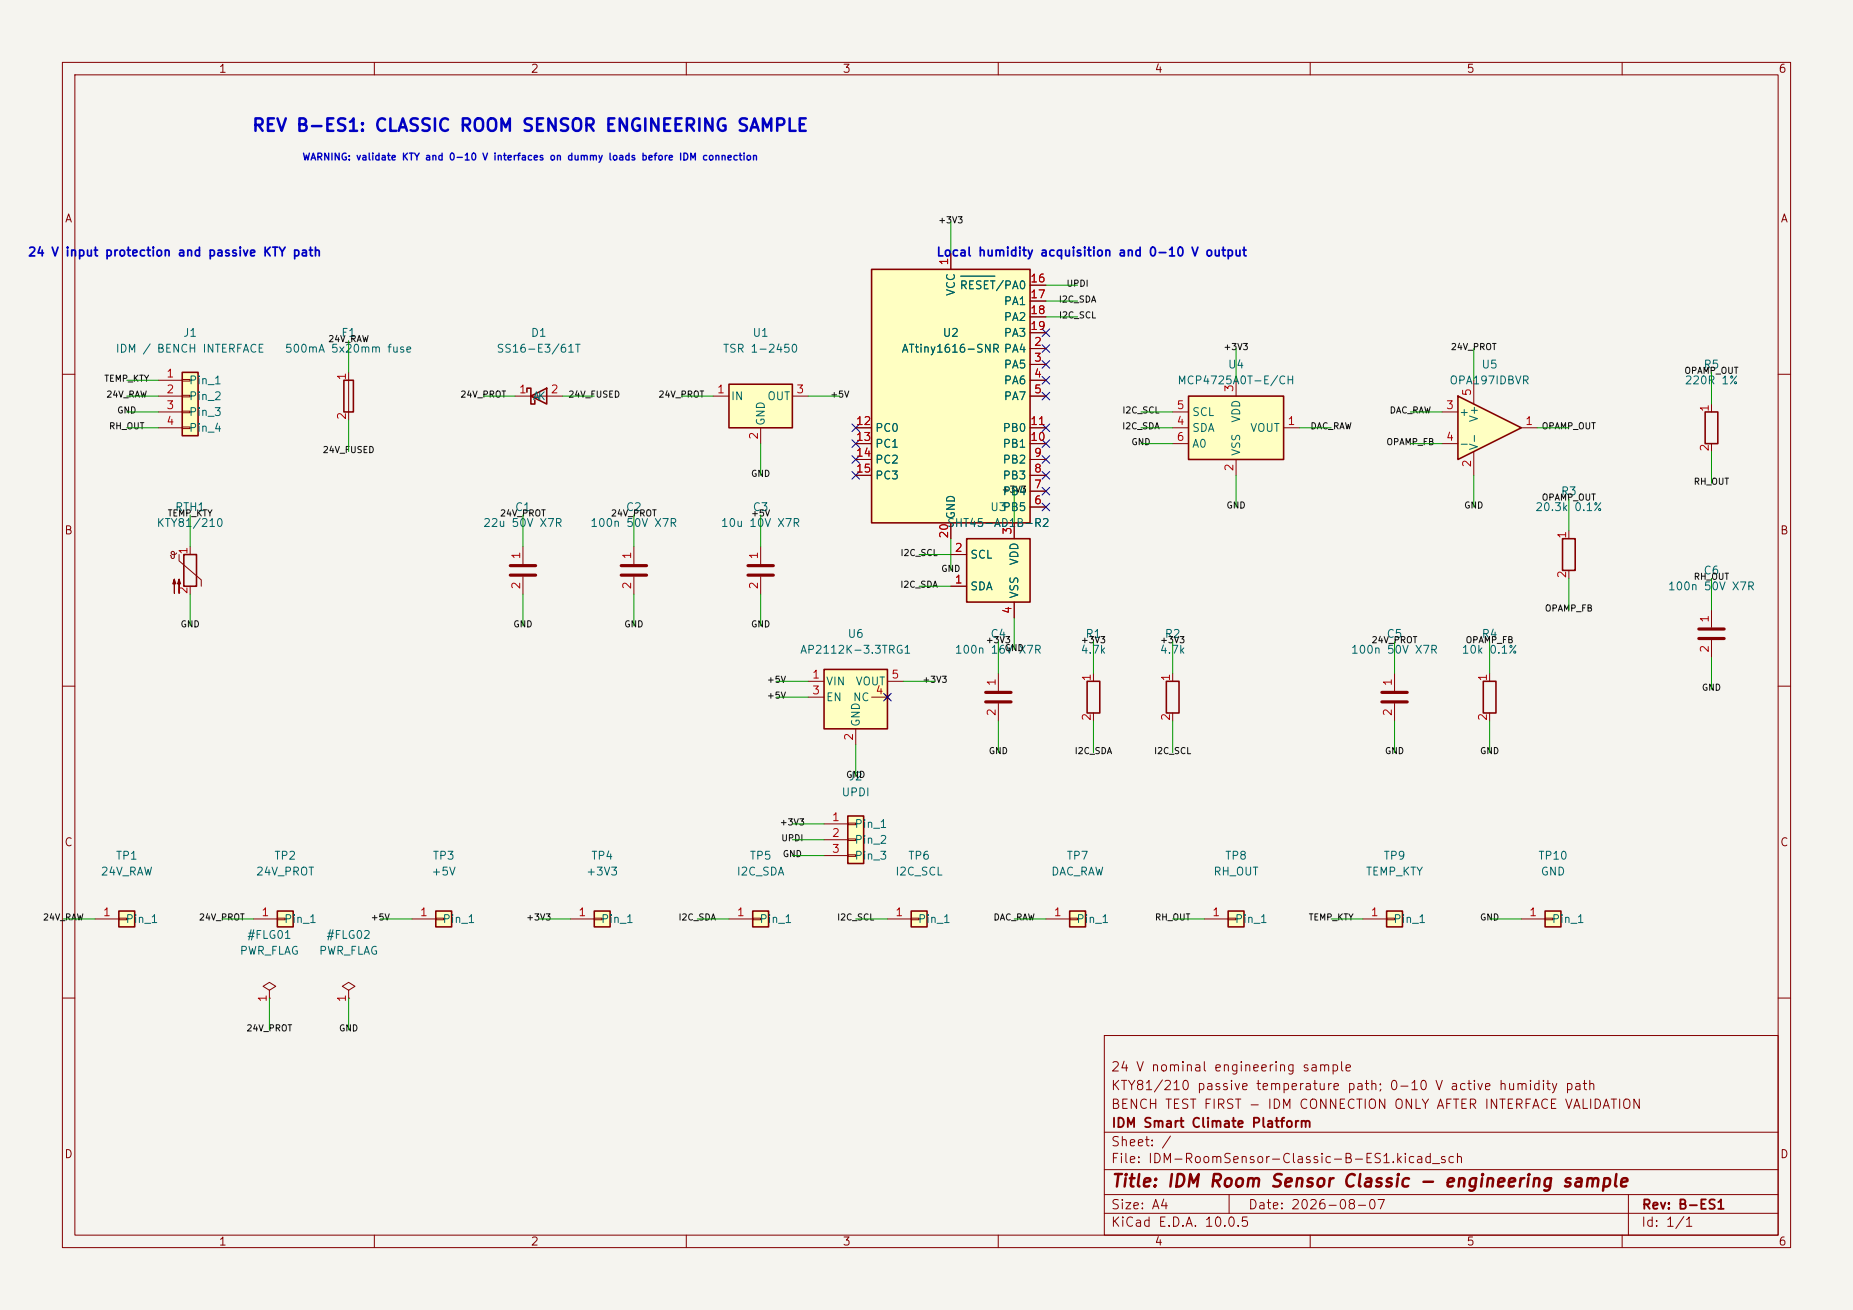
[picture p27: page 1]

UPDI WARNING: validate KTY and 0-10 V interfaces on dummy loads before IDM connection REV B-ES1: CLASSIC ROOM SENSOR ENGINEERING SAMPLE
500mA 5x20mm fuse 1 #FLG02 PWR_FLAG

24 V nominal engineering sample
KTY81/210 passive temperature path; 0-10 V active humidity path
BENCH TEST FIRST - IDM CONNECTION ONLY AFTER INTERFACE VALIDATION
IDM Smart Climate Platform
Sheet: /
File: IDM-RoomSensor-Classic-B-ES1.kicad_sch
Title: IDM Room Sensor Classic - engineering sample

Size: A4 | Rev: B-ES1
KiCad E.D.A. 10.0.5 | Id: 1/1
