Xerolux/IDM-Smart-Climate-Platform/hardware/esp-sensor/manufacturing/B-ES1/schematic.pdf

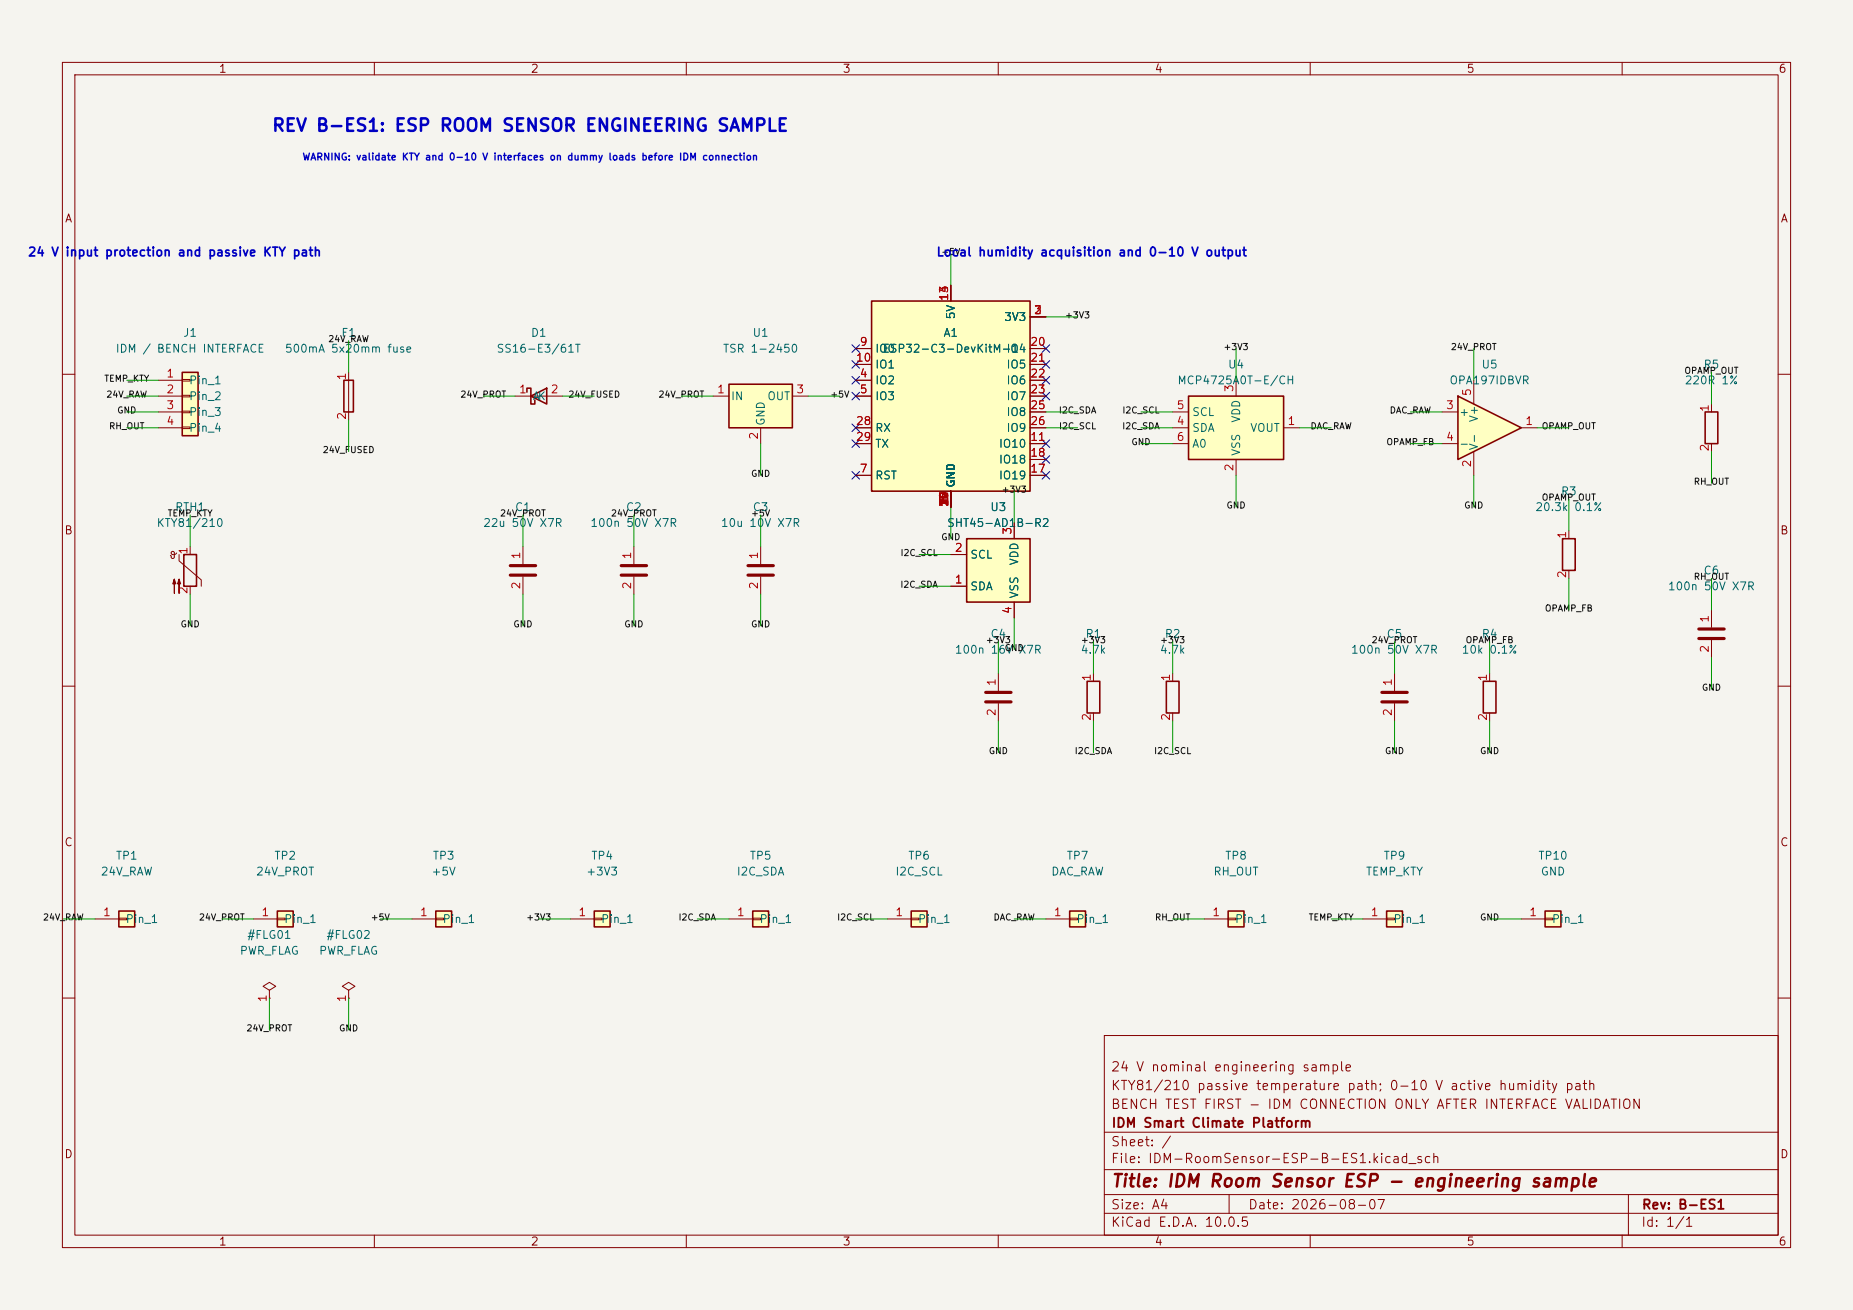
[picture p28: page 1]

REV B-ES1: ESP ROOM SENSOR ENGINEERING SAMPLE

Local humidity acquisition and 0-10 V output U3
IO10 11 GND 12 5V 134 GND 156

24 V nominal engineering sample
KTY81/210 passive temperature path; 0-10 V active humidity path
BENCH TEST FIRST - IDM CONNECTION ONLY AFTER INTERFACE VALIDATION
IDM Smart Climate Platform
Sheet: /
File: IDM-RoomSensor-ESP-B-ES1.kicad_sch
Title: IDM Room Sensor ESP - engineering sample

Size: A4 | Rev: B-ES1
KiCad E.D.A. 10.0.5 | Id: 1/1
