Xerolux/IDM-Smart-Climate-Platform/hardware/fake-sensor/manufacturing/B-ES1/IDM-FakeSensor-ESP-schematic.pdf

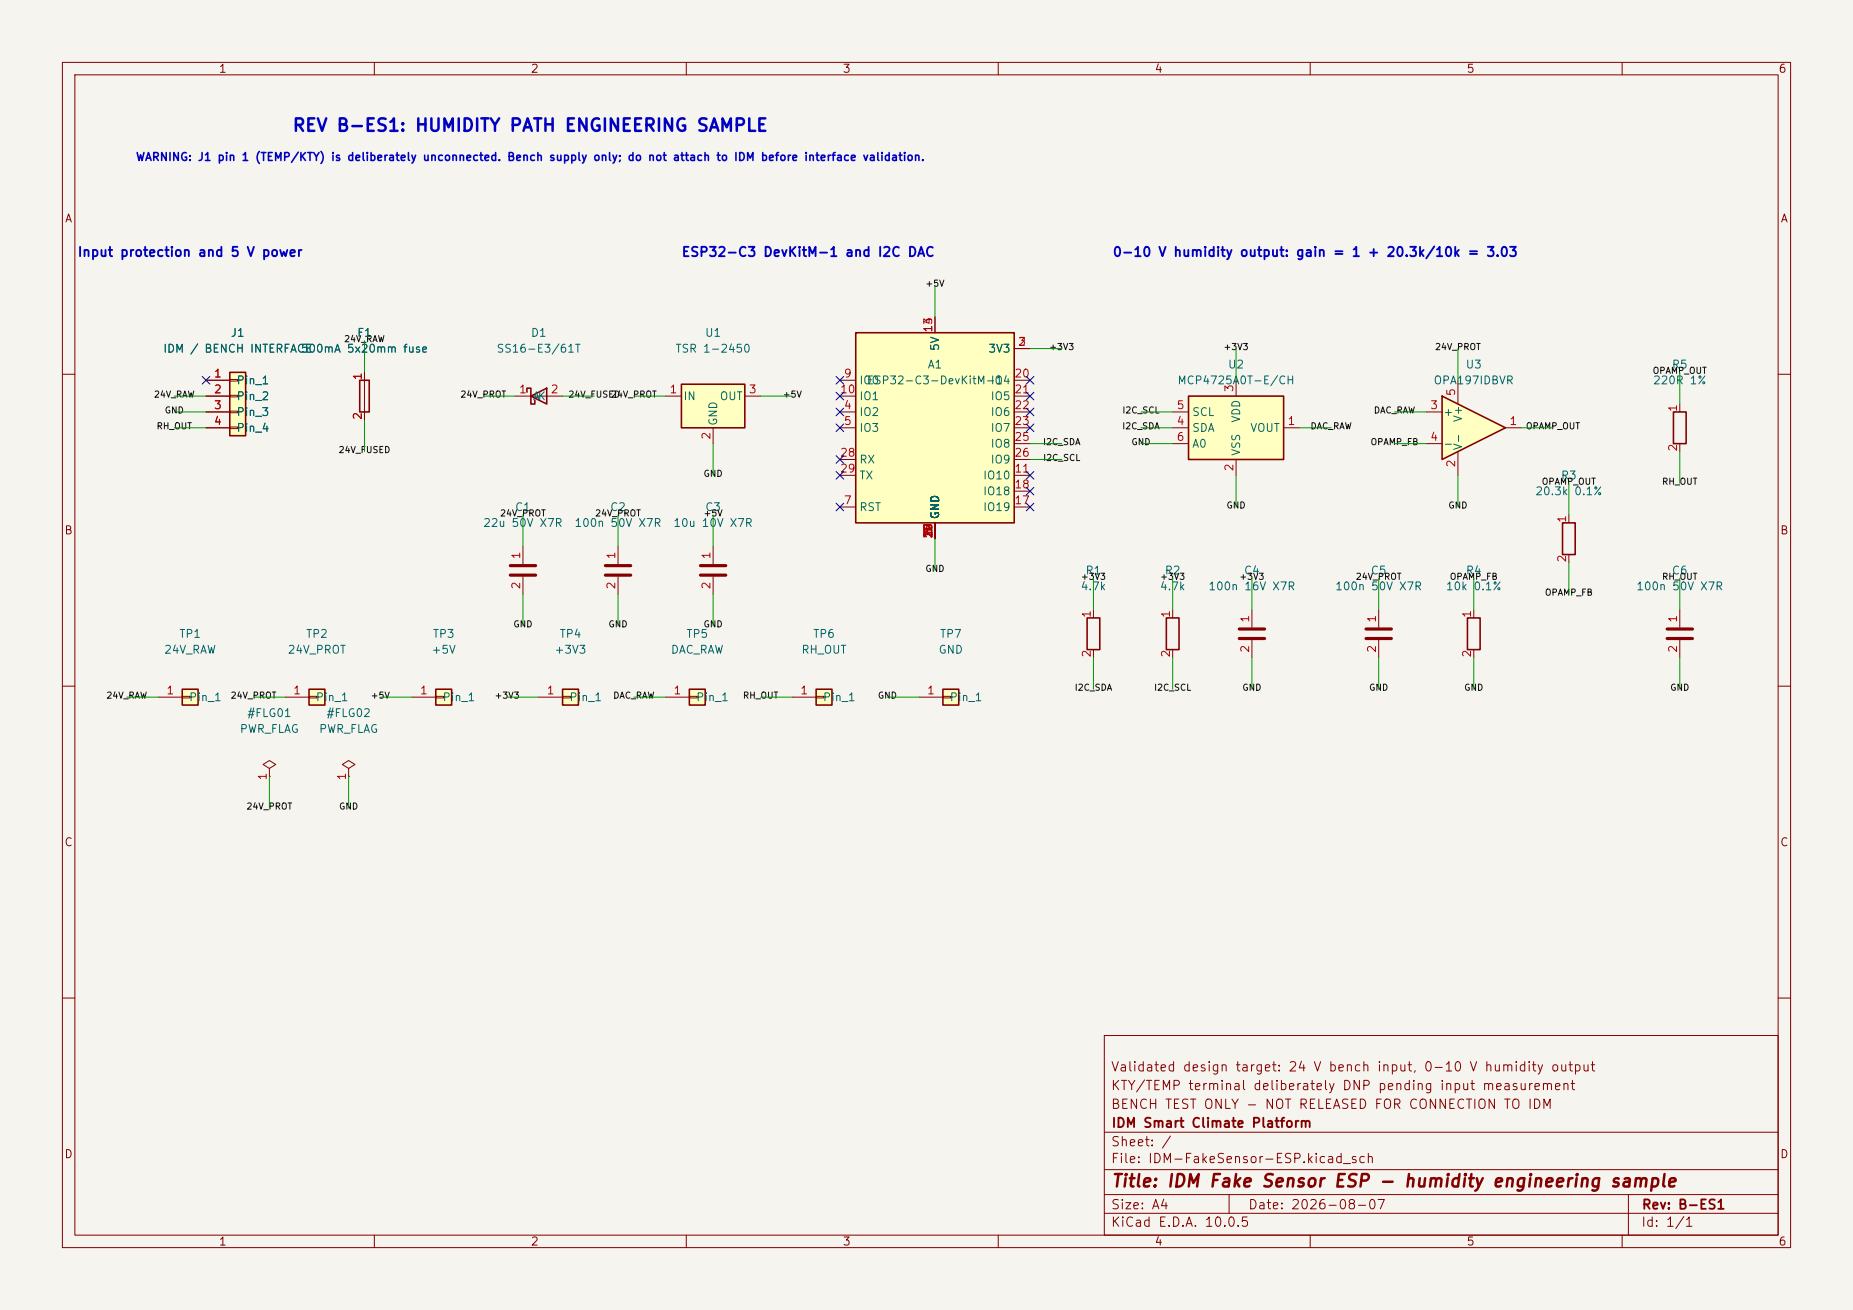
[picture p29: page 1]

Validated design target: 24 V bench input, 0-10 V humidity output 1 #FLG01 PWR_FLAG

KTY/TEMP terminal deliberately DNP pending input measurement
BENCH TEST ONLY - NOT RELEASED FOR CONNECTION TO IDM
IDM Smart Climate Platform
Sheet: /
File: IDM-FakeSensor-ESP.kicad_sch
Title: IDM Fake Sensor ESP - humidity engineering sample

Size: A4 | Rev: B-ES1
KiCad E.D.A. 10.0.5 | Id: 1/1
