Xerolux/IDM-Smart-Climate-Platform/hardware/esp-sensor/manufacturing/B-ES5-MODULAR/Modules/AIR-CO2/AIR-CO2-schematic.pdf

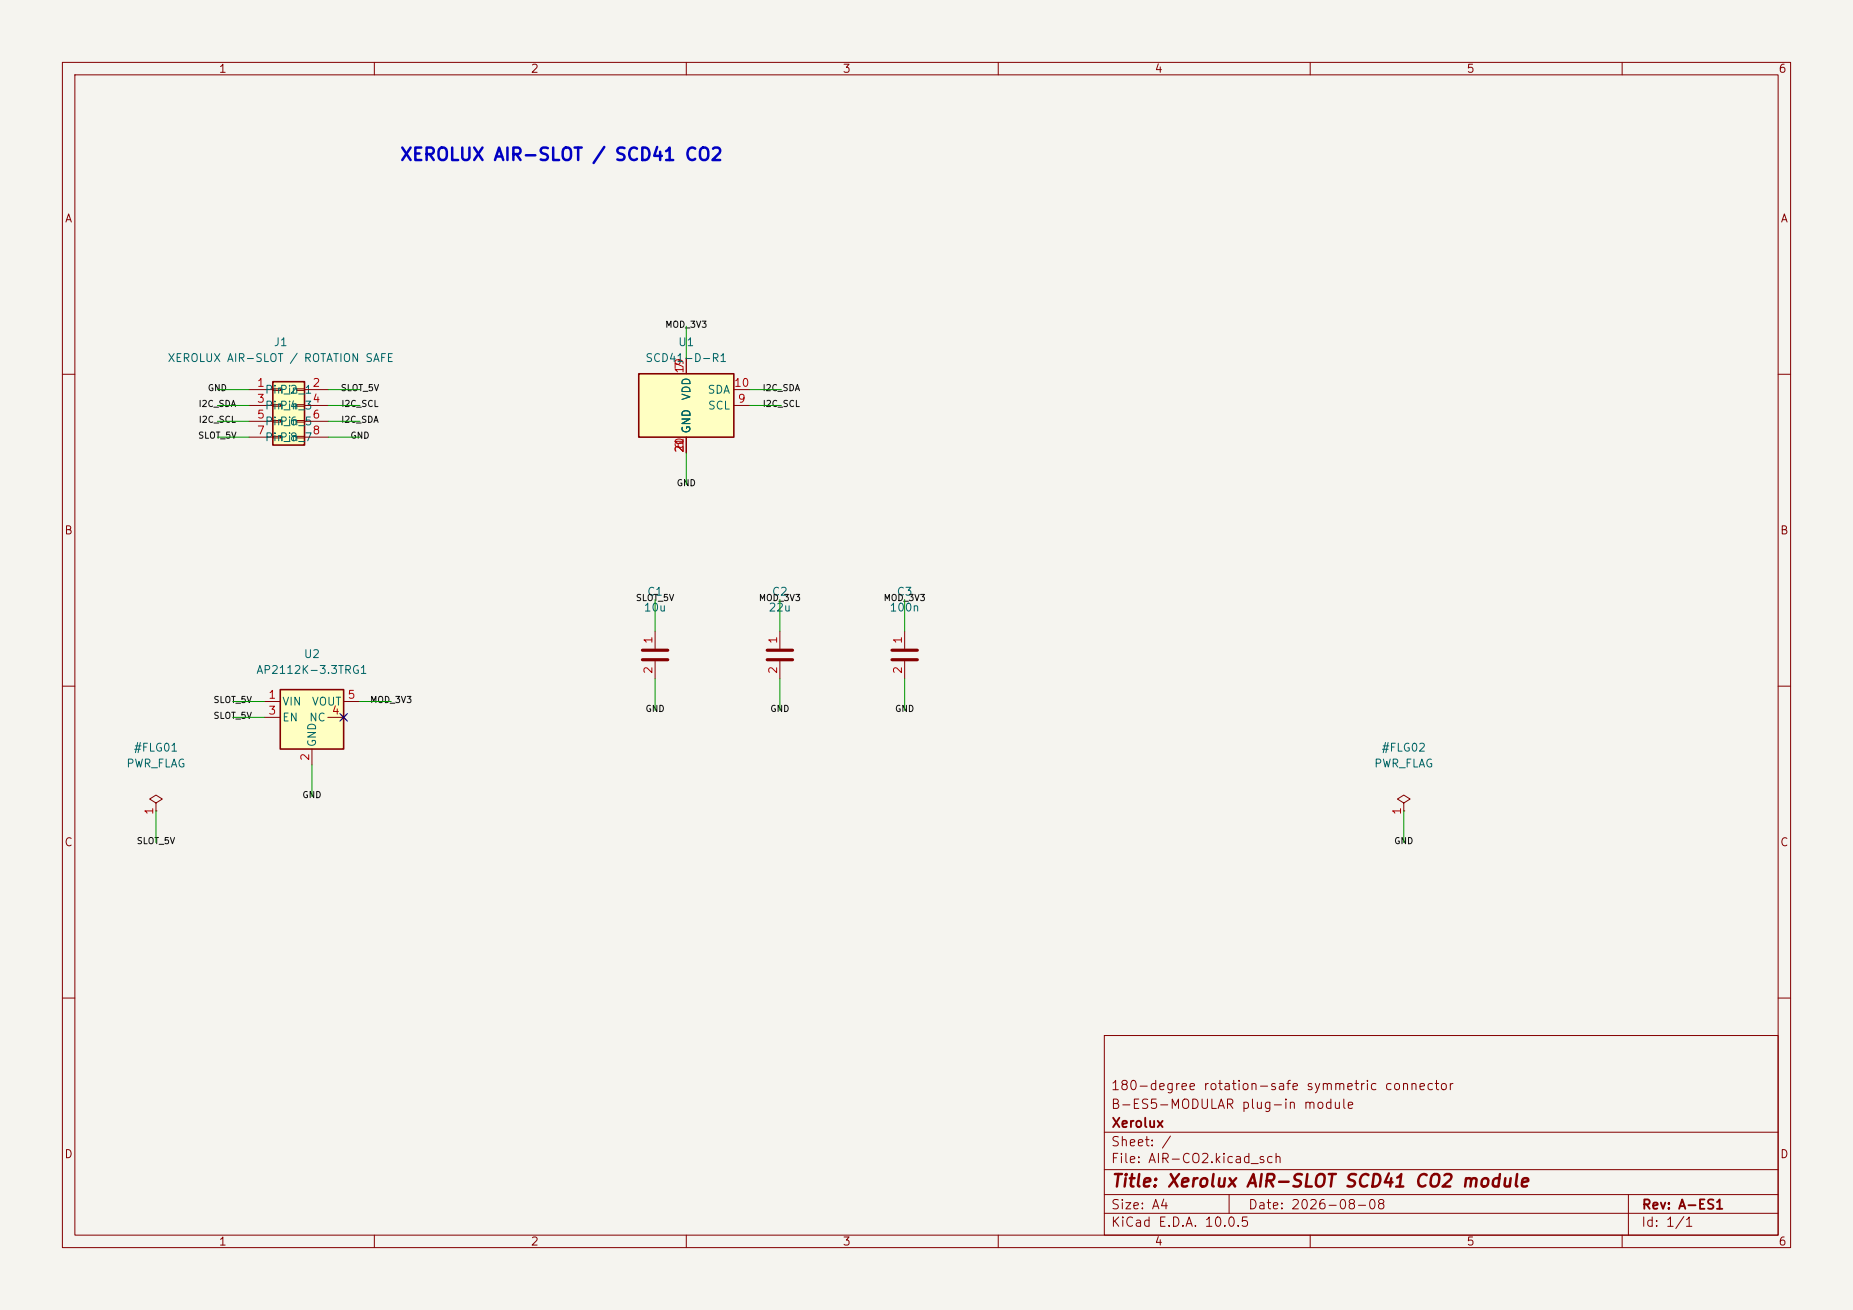
[picture p30: page 1]

XEROLUX AIR-SLOT / ROTATION SAFE

180-degree rotation-safe symmetric connector 1 #FLG01 PWR_FLAG

B-ES5-MODULAR plug-in module
Xerolux
Sheet: /
File: AIR-CO2.kicad_sch
Title: Xerolux AIR-SLOT SCD41 CO2 module

Size: A4 | Rev: A-ES1
KiCad E.D.A. 10.0.5 | Id: 1/1
