Xerolux/IDM-Smart-Climate-Platform/hardware/esp-sensor/manufacturing/B-ES5-MODULAR/Modules/AIR-PRESSURE/AIR-PRESSURE-schematic.pdf

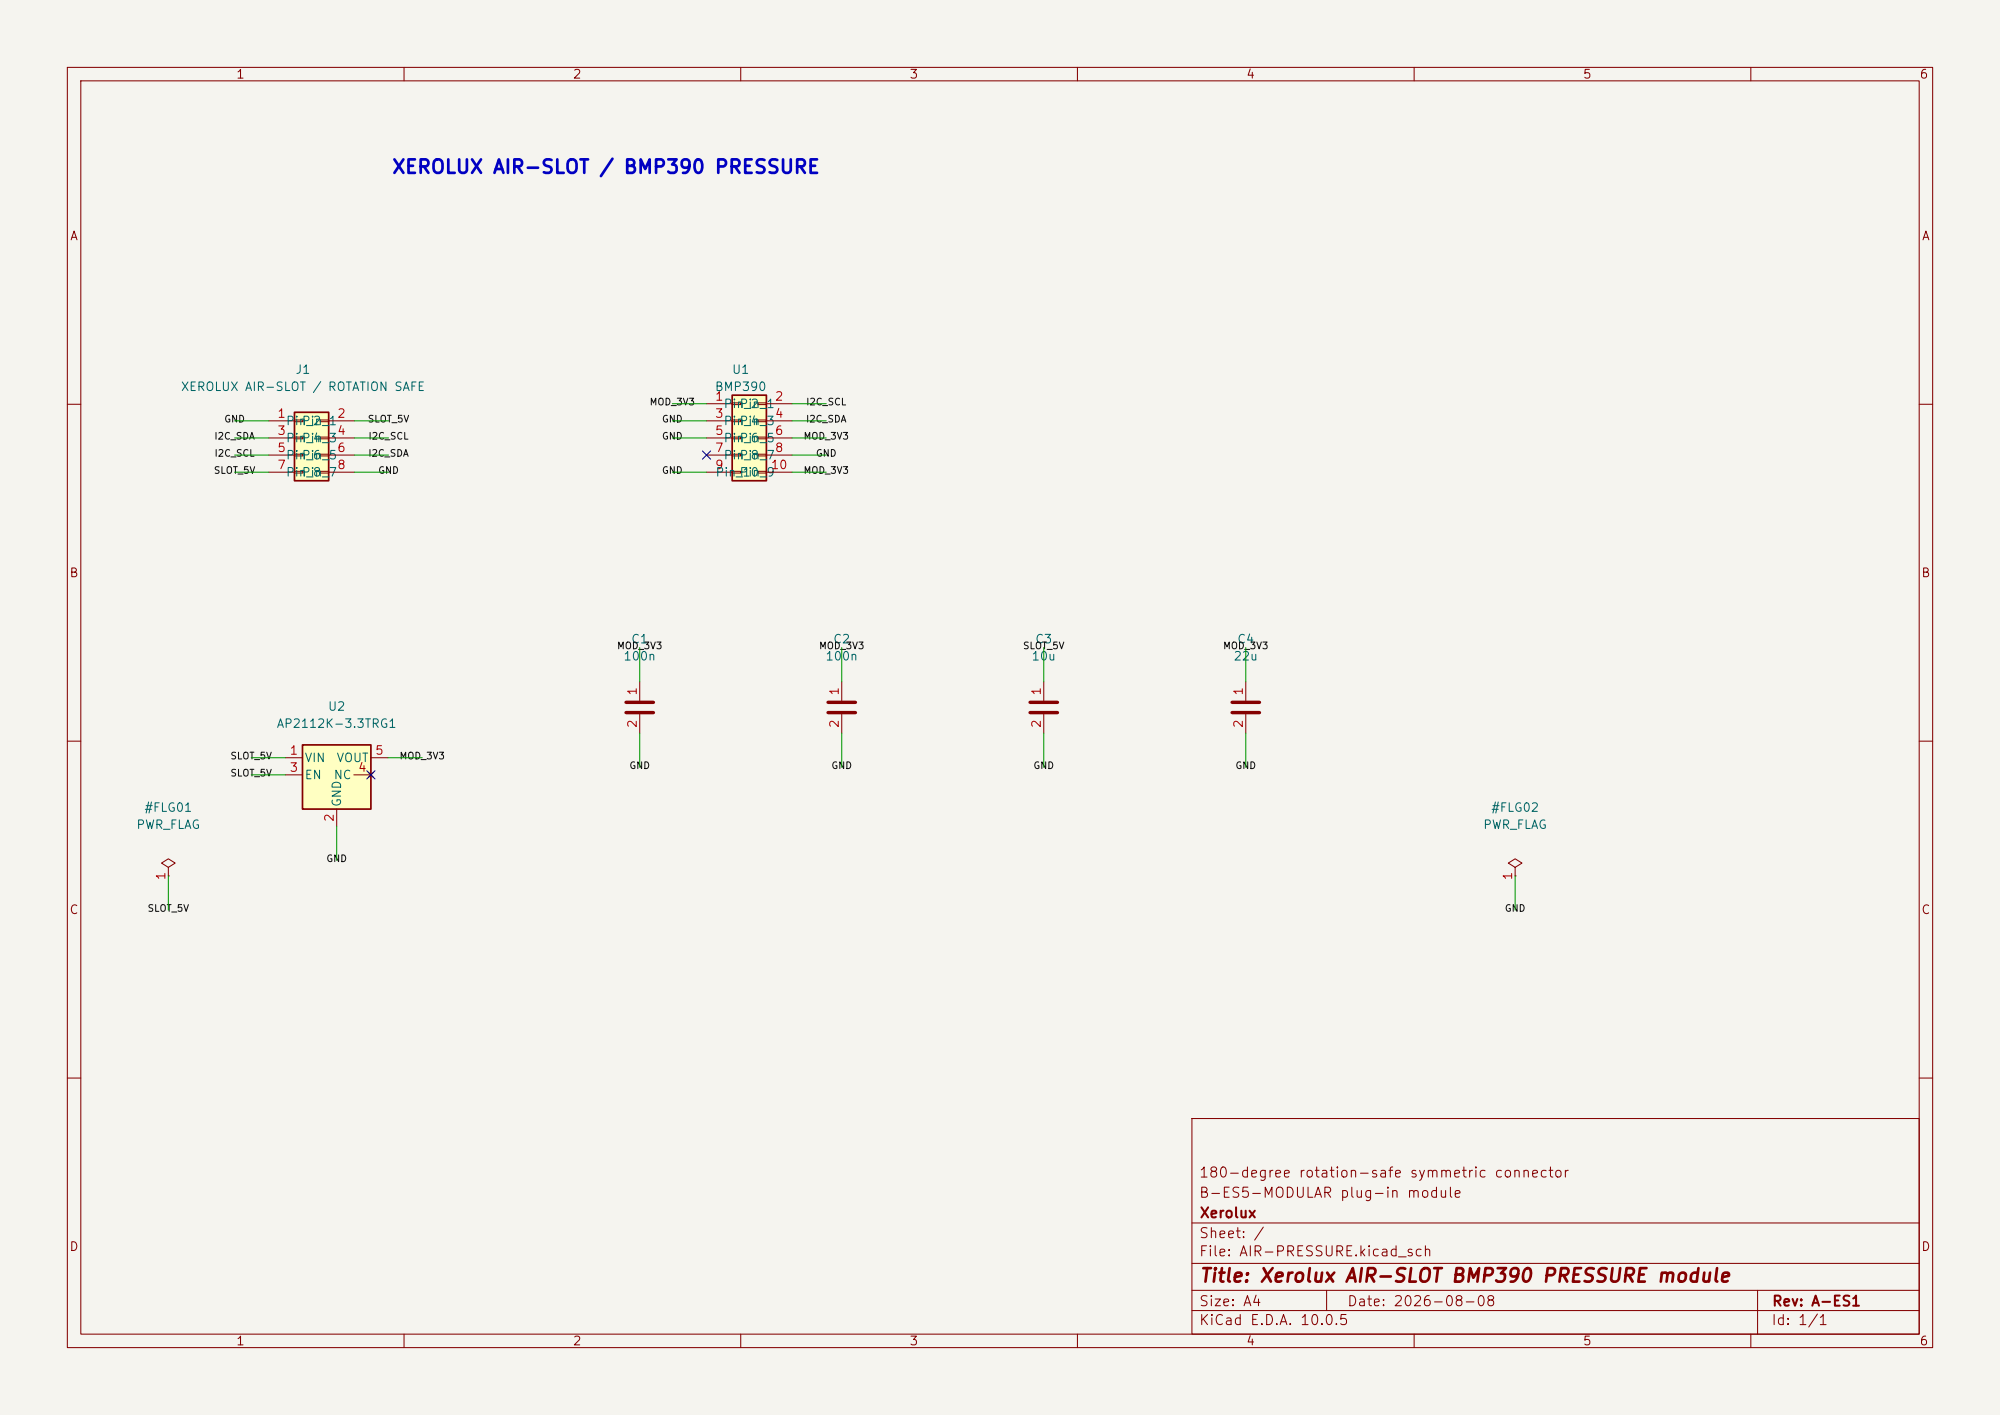
[picture p31: page 1]

I2C_SCL XEROLUX AIR-SLOT / BMP390 PRESSURE

180-degree rotation-safe symmetric connector 1 2 C4

B-ES5-MODULAR plug-in module
Xerolux
Sheet: /
File: AIR-PRESSURE.kicad_sch
Title: Xerolux AIR-SLOT BMP390 PRESSURE module

Size: A4 | Rev: A-ES1
KiCad E.D.A. 10.0.5 | Id: 1/1
