Xerolux/IDM-Smart-Climate-Platform/hardware/esp-sensor/manufacturing/B-ES5-MODULAR/Modules/AIR-VOCNOX/AIR-VOCNOX-schematic.pdf

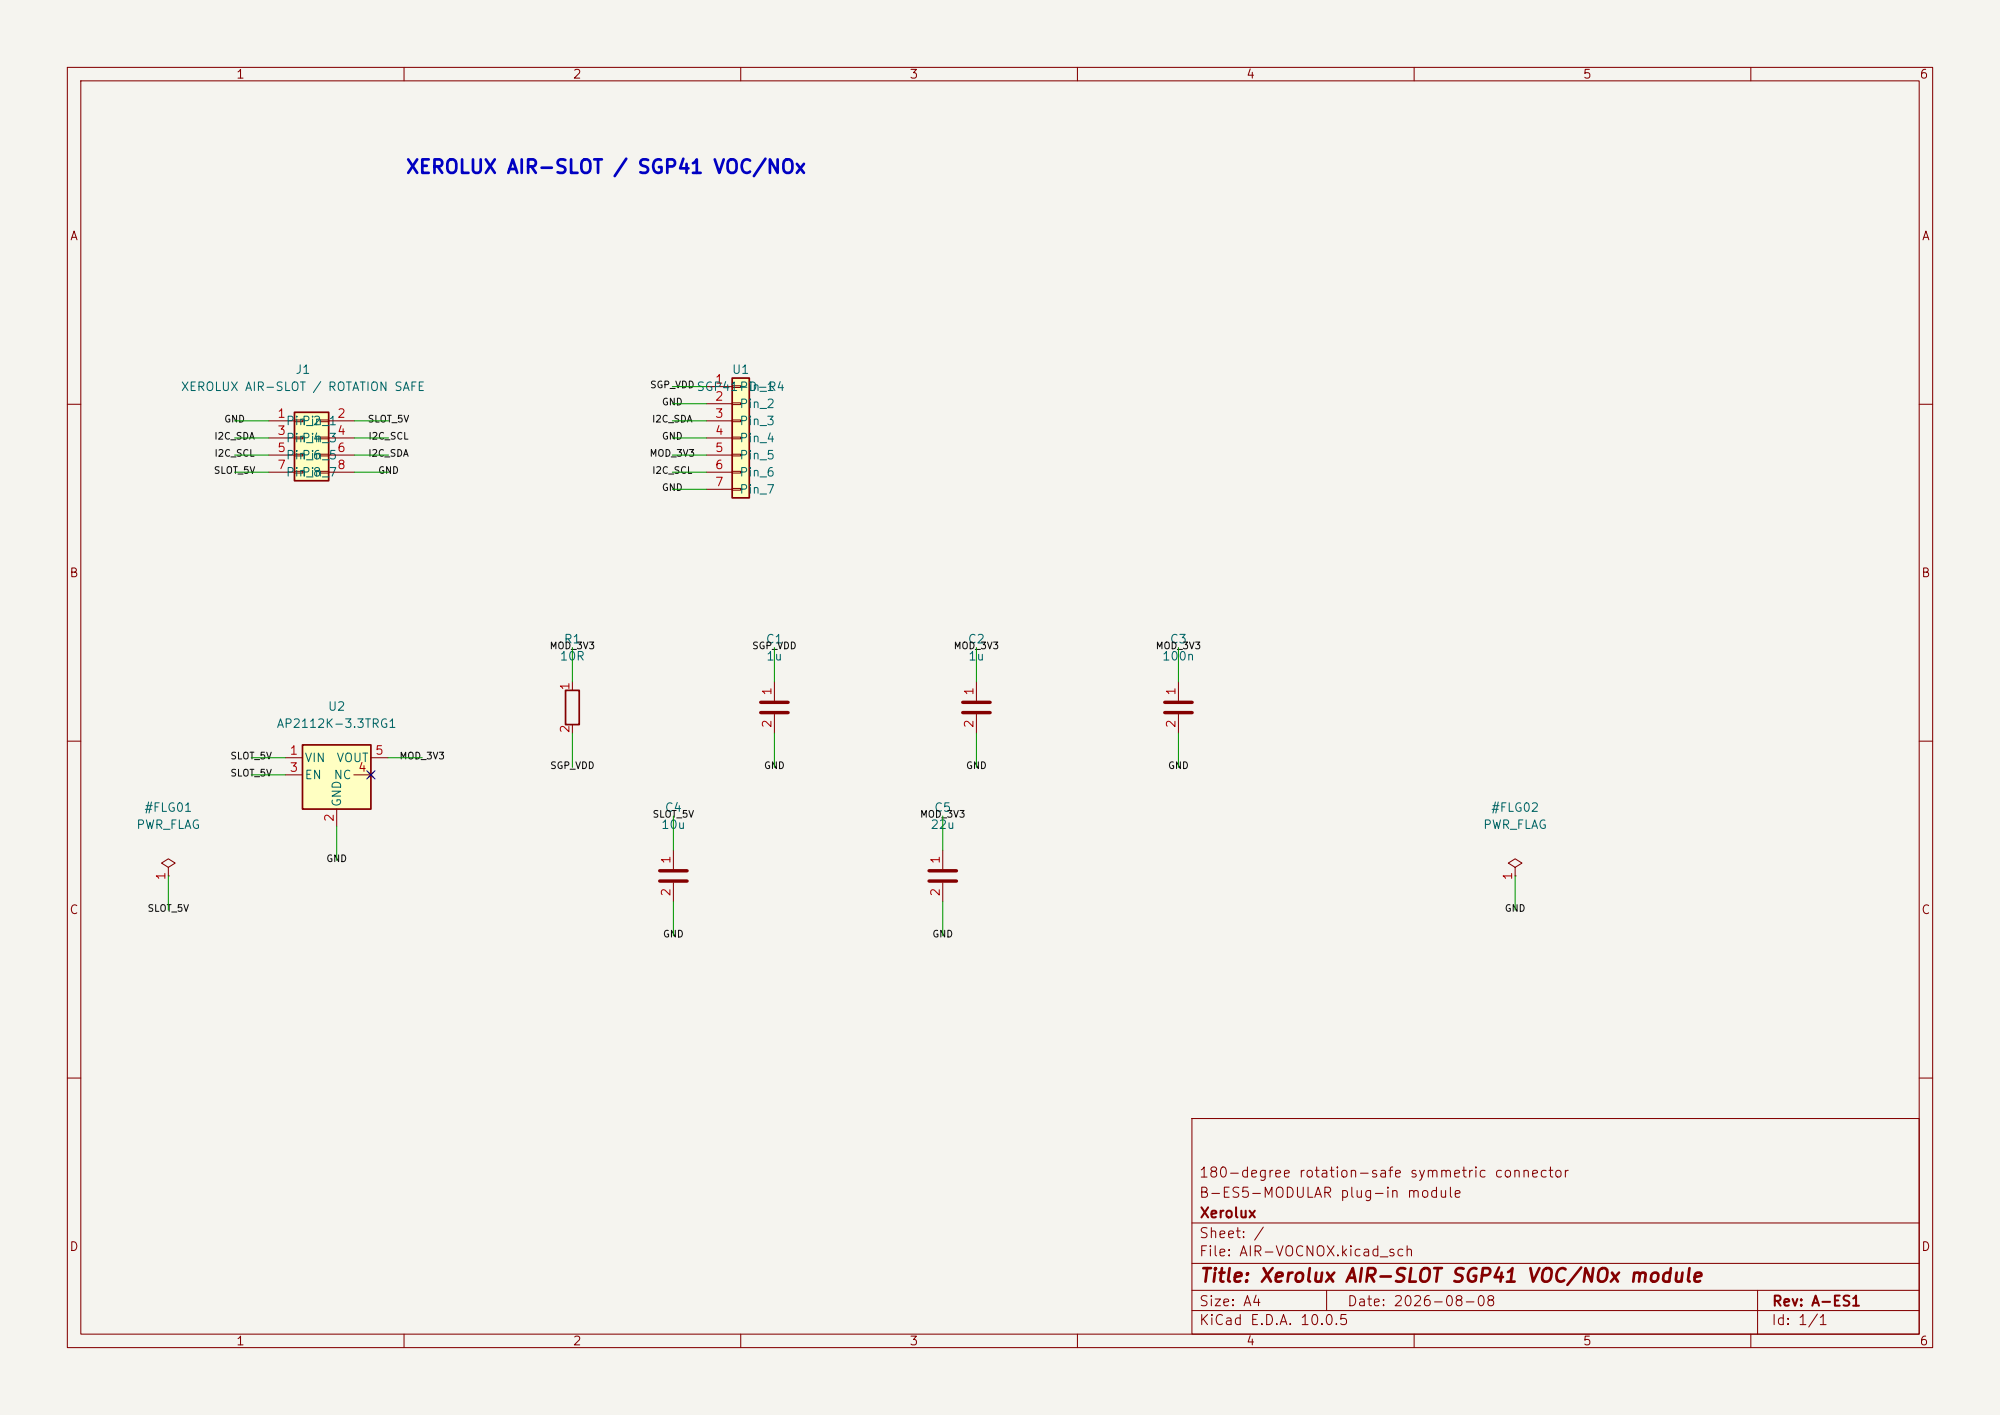
[picture p32: page 1]

SLOT_5V SLOT_5VMOD_3V3 XEROLUX AIR-SLOT / SGP41 VOC/NOx

180-degree rotation-safe symmetric connector 1 2 C2

B-ES5-MODULAR plug-in module
Xerolux
Sheet: /
File: AIR-VOCNOX.kicad_sch
Title: Xerolux AIR-SLOT SGP41 VOC/NOx module

Size: A4 | Rev: A-ES1
KiCad E.D.A. 10.0.5 | Id: 1/1
