Xerolux/IDM-Smart-Climate-Platform/(list of files, drawings)

Other design files:
hardware/classic-sensor/manufacturing/B-ES1/design.dsn
hardware/esp-sensor/manufacturing/B-ES1/design.dsn
