Xerolux/IDM-Smart-Climate-Platform/hardware/esp-sensor/IDM-RoomSensor-ESP-B-ES4-AIR-R2.kicad_pcb

## KiCad design hardware/esp-sensor/IDM-RoomSensor-ESP-B-ES4-AIR-R2.kicad_pcb (2026-08-08)

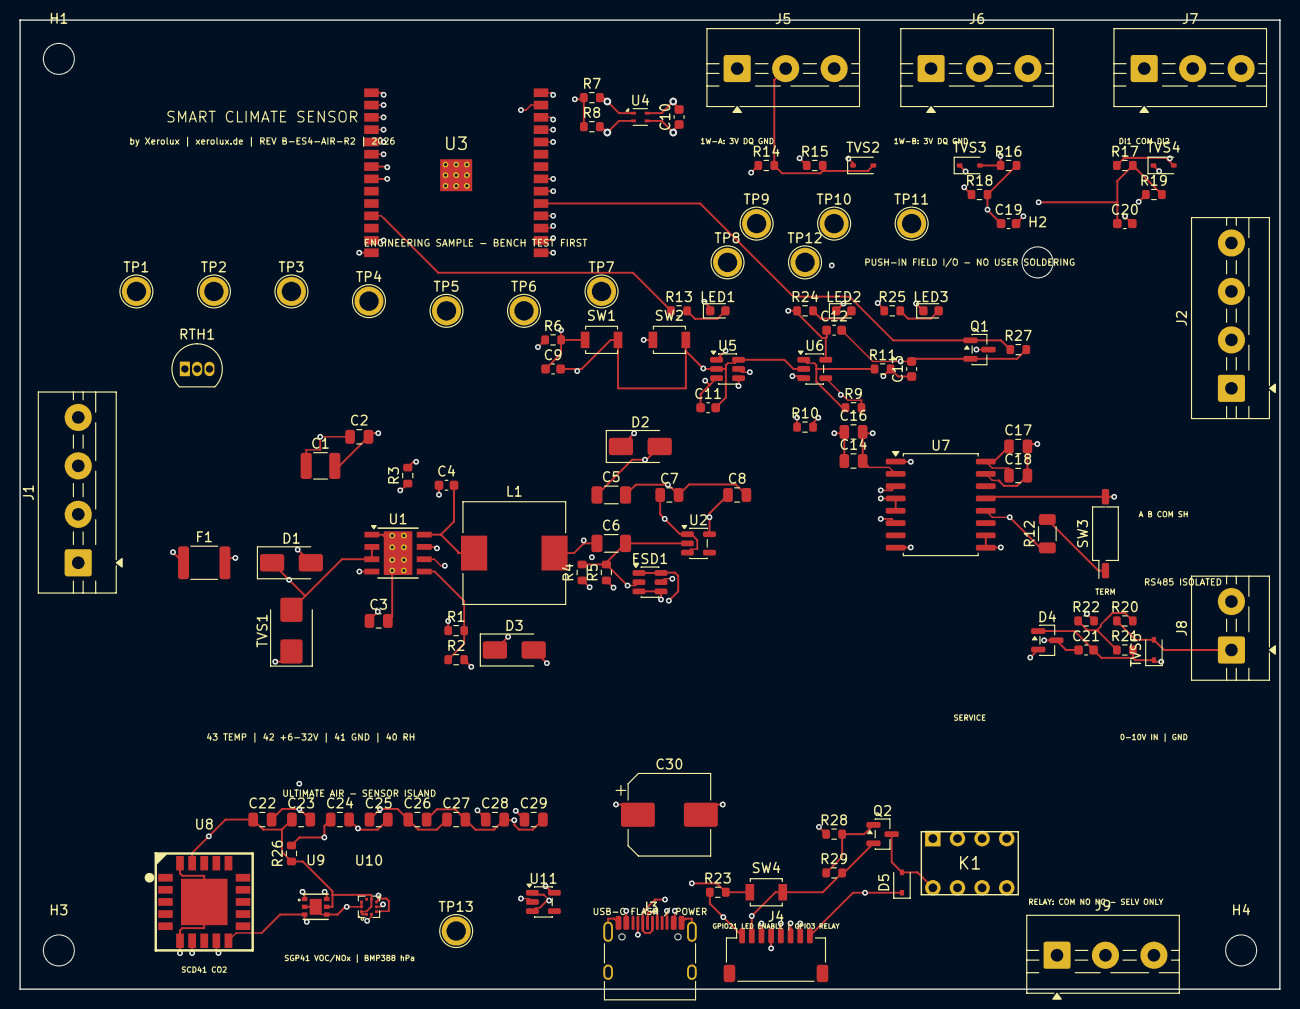
[picture p33: board IDM-RoomSensor-ESP-B-ES4-AIR-R2.kicad_pcb from above]

Board: 4 copper layers, 130.0 x 100.0 mm, 119 parts (0 on the bottom side), 61 nets.

Parts:
C1: 4.7u 100V; C_1210_3225Metric
C2: 220n 100V; C_0805_2012Metric
C3, C24, C25: 1u; C_0805_2012Metric
C4, C10, C11, C19, C20, C21: 100n; C_0603_1608Metric
C5, C6: 47u; C_1206_3216Metric
C7, C16, C18, C28: 10u; C_0805_2012Metric
C8, C29: 22u; C_0805_2012Metric
C9: 1u; C_0603_1608Metric
C12, C13: 100n 50V; C_0603_1608Metric
C14, C17, C22, C26, C27: 100n; C_0805_2012Metric
C23: 4.7u; C_0805_2012Metric
C30: 220u 10V; CP_Elec_8x10
D1: SS16; D_SMA
D2, D3: SS14; D_SMA
D4: BAT54S; SOT-23
D5: 1N4148WS FLYBACK; D_SOD-323
ESD1: USBLC6-2SC6; SOT-23-6
F1: BSMD1812-050-60V; Fuse_1812_4532Metric
H1, H2, H3, H4: MountingHole_3.2mm_M3
J1: MX205R PUSH-IN 43/42/41/40; TerminalBlock_MaiXu_MX126-5.0-04P_1x04_P5.00mm
J2: MX205R PUSH-IN RS485 A/B/COM/SH; TerminalBlock_MaiXu_MX126-5.0-04P_1x04_P5.00mm
J3: USB-C; USB_C_Receptacle_HRO_TYPE-C-31-M-12
J4: EXPANSION; JST_SH_SM08B-SRSS-TB_1x08-1MP_P1.00mm_Horizontal
J5: 1WIRE A 3V/DQ/GND; TerminalBlock_MaiXu_MX126-5.0-03P_1x03_P5.00mm
J6: 1WIRE B 3V/DQ/GND; TerminalBlock_MaiXu_MX126-5.0-03P_1x03_P5.00mm
J7: CONTACT 1/COM/2; TerminalBlock_MaiXu_MX126-5.0-03P_1x03_P5.00mm
J8: 0-10V IN/GND; TerminalBlock_MaiXu_MX126-5.0-02P_1x02_P5.00mm
J9: RELAY COM/NO/NC; TerminalBlock_MaiXu_MX126-5.0-03P_1x03_P5.00mm
K1: HFD4/5; Relay_Hongfa_HFD4_DIP
L1: SRP1038A-330M; L_10.4x10.4_H4.8
LED1: STATUS; LED_0603_1608Metric
LED2: VIN; LED_0603_1608Metric
LED3: BUS GREEN; LED_0603_1608Metric
Q1: 2N7002 VIN LED; SOT-23
Q2: 2N7002 RELAY; SOT-23
R1, R3, R27, R29: 100k; R_0603_1608Metric
R2: 24.9k; R_0603_1608Metric
R4, R5: 5.1k; R_0603_1608Metric
R6, R10, R18, R19, R21, R23: 10k; R_0603_1608Metric
R7, R8, R15: 4.7k; R_0603_1608Metric
R9: 21k 1% CAL; R_0603_1608Metric
R11: 220R; R_0603_1608Metric
R12: 120R; R_1206_3216Metric
R13, R16, R17, R22, R25: 1k; R_0603_1608Metric
R14, R28: 100R; R_0603_1608Metric
R20: 33k; R_0603_1608Metric
R24: 18k; R_0603_1608Metric
R26: 10R; R_0603_1608Metric
RTH1: KTY81/210,112; TO-92_Inline
SW1: RESET; SW_SPST_B3U-1000P
SW2: BOOT; SW_SPST_B3U-1000P
SW3: TERM ON/OFF; SW_DIP_SPSTx01_Slide_Copal_CHS-01B_W7.62mm_P1.27mm
SW4: SERVICE; SW_SPST_B3U-1000P
TP1: 24V_RAW; TestPoint_Plated_Hole_D2.0mm
TP2: 24V_PROT; TestPoint_Plated_Hole_D2.0mm
TP3: SYS_5V; TestPoint_Plated_Hole_D2.0mm
TP4: +3V3; TestPoint_Plated_Hole_D2.0mm
TP5: I2C_SDA; TestPoint_Plated_Hole_D2.0mm
TP6: I2C_SCL; TestPoint_Plated_Hole_D2.0mm
TP7: RH_OUT; TestPoint_Plated_Hole_D2.0mm
TP8: TEMP_KTY; TestPoint_Plated_Hole_D2.0mm
TP9: RS485_A; TestPoint_Plated_Hole_D2.0mm
TP10: RS485_B; TestPoint_Plated_Hole_D2.0mm
TP11: RS485_COM; TestPoint_Plated_Hole_D2.0mm
TP12: GND; TestPoint_Plated_Hole_D2.0mm
TP13: AIR_3V3; TestPoint_Plated_Hole_D2.0mm
TVS1: SMBJ33A; D_SMB
TVS2, TVS3, TVS4: 3V3 ESD; D_SOD-323
TVS5: 12V ESD; D_SOD-323
U1: LMR36510ADDAR; TI_SO-PowerPAD-8_ThermalVias
U2: AP2112K-3.3; SOT-23-5
U3: ESP32-C6-WROOM-1-N8; ESP32-C6-WROOM-1
U4: SHT45; Sensirion_DFN-4_1.5x1.5mm_P0.8mm_SHT4x_NoCentralPad
U5: MCP4725A0T; SOT-23-6
U6: OPA197IDBVR; SOT-23-5
U7: CA-IS3092W; SOIC-16W_7.5x10.3mm_P1.27mm
U8: SCD41-D-R1; SENSOR-SMD_SCD41-D-R1
U9: SGP41-D-R4; DFN-6_L2.4-W2.4-P0.80-TL-EP
U10: BMP388; LGA-10_L2.0-W2.0-P0.50-BL
U11: AP2112K-3.3 AIR; SOT-23-5

Connections:
5V_BUCK: C5.1, C6.1, D2.2, L1.2, R1.1, R3.2
24V_FUSED: D1.2, F1.2
24V_PROT: C1.1, C2.1, C12.1, D1.1, R24.1, TP2.1, TVS1.2, U1.2, U1.3, U6.5
24V_RAW: F1.1, J1.2, TP1.1
+3V3: C8.1, C10.1, C11.1, C14.1, C16.1, D4.2, J4.1, J5.1, J6.1, R6.1, R7.1, R8.1, R15.1, R18.1, R19.1, R23.1, TP4.1, U2.5, U3.2, U4.3, U5.3, U7.1
ADC_0_10: C21.1, D4.3, R22.2, U3.8
AIN_0_10_RAW: J8.1, R20.1, TVS5.2
AIN_DIV: R20.2, R21.1, R22.1
AIR_3V3: C22.1, C23.1, C25.1, C26.1, C27.1, C29.1, R26.1, TP13.1, U8.7, U8.19, U9.5, U10.1, U10.6, U10.10, U11.5
BOOT: C4.1, U1.7
BUCK_FB: R1.2, R2.1, U1.5
BUS_LED: R25.1, U3.20
BUS_LED_R: LED3.2, R25.2
C6_BOOT: SW2.1, U3.15
C6_EN: C9.1, R6.2, SW1.1, U3.3
CONTACT1: C19.1, R16.2, R18.2, U3.16
CONTACT1_EXT: J7.1, R16.1, TVS3.2
CONTACT2: C20.1, R17.2, R19.2, U3.17
CONTACT2_EXT: J7.3, R17.1, TVS4.2
DAC_RAW: U5.1, U6.3
EXP_GPIO4: J4.6, U3.4
EXP_GPIO5: J4.7, U3.5
GND: C1.2, C2.2, C3.2, C5.2, C6.2, C7.2, C8.2, C9.2, C10.2, C11.2, C12.2, C13.2, C14.2, C16.2, C19.2, C20.2, C21.2, C22.2, C23.2, C24.2, C25.2, C26.2, C27.2, C28.2, C29.2, C30.2, D4.1, ESD1.2, J1.3, J3.A1, J3.A12, J3.B1, J3.B12, J3.SH, J4.2, J5.3, J6.3, J7.2, J8.2, LED1.1, LED3.1, Q1.2, Q2.2, R2.2, R4.2, R5.2, R10.2, R21.2, R27.2, R29.2, RTH1.2, SW1.2, SW2.2, SW4.2, TP12.1, TVS1.1, TVS2.1, TVS3.1, TVS4.1, TVS5.1, U1.1, U1.9, U2.2, U3.1, U3.28, U3.29, U4.4, U5.2, U5.6, U6.2, U7.2, U7.8, U8.6, U8.20, U8.21, U9.2, U9.4, U9.7, U10.3, U10.5, U10.8, U10.9, U11.2
I2C_SCL: J4.4, R8.2, TP6.1, U3.7, U4.2, U5.5, U8.9, U9.6, U10.2
I2C_SDA: J4.3, R7.2, TP5.1, U3.6, U4.1, U5.4, U8.10, U9.3, U10.4
ONEWIRE: J4.5, R14.1, U3.21
ONEWIRE_EXT: J5.2, J6.2, R14.2, R15.2, TVS2.2
OPAMP_FB: R9.2, R10.1, U6.4
OPAMP_OUT: R9.1, R11.1, U6.1
PWR24_LED_R: LED2.2, R24.2
PWR_GOOD: R3.1, U1.4
PWR_LED_EN: Q1.1, R27.1, U3.19
PWR_LED_K: LED2.1, Q1.3
RELAY_COIL_L: D5.2, K1.8, Q2.3
RELAY_COM: J9.1, K1.3
RELAY_CTRL: R28.1, U3.26
RELAY_GATE: Q2.1, R28.2, R29.1
RELAY_NC: J9.3, K1.2
RELAY_NO: J9.2, K1.4
RH_OUT: C13.1, J1.4, R11.2, TP7.1
RS485_A: J2.1, R12.1, TP9.1, U7.12
RS485_B: J2.2, SW3.2, TP10.1, U7.13
RS485_COM: C17.2, C18.2, J2.3, TP11.1, U7.9, U7.10, U7.15
RS485_DE: U3.27, U7.4, U7.5
RS485_RX: U3.24, U7.3
RS485_TERM: R12.2, SW3.1
RS485_TX: U3.25, U7.6
SERVICE_BUTTON: R23.2, SW4.1, U3.18
SGP_VDD: C24.1, R26.2, U9.1
STATUS_LED: R13.1, U3.11
STATUS_LED_R: LED1.2, R13.2
SW: C4.2, L1.1, U1.8
SYS_5V: C7.1, C28.1, C30.1, D2.1, D3.1, D5.1, J4.8, K1.1, TP3.1, U2.1, U2.3, U11.1, U11.3
TEMP_KTY: J1.1, RTH1.1, TP8.1
USB_5V: D3.2, ESD1.5, J3.A4, J3.A9, J3.B4, J3.B9
USB_CC1: J3.A5, R4.1
USB_CC2: J3.B5, R5.1
USB_D+: ESD1.3, ESD1.4, J3.A6, J3.B6, U3.14
USB_D-: ESD1.1, ESD1.6, J3.A7, J3.B7, U3.13
VCC_BYP: C3.1, U1.6
VISO: C17.1, C18.1, U7.16
