Xerolux/IDM-Smart-Climate-Platform/hardware/esp-sensor/modules/AIR-CO2/AIR-CO2.kicad_pcb

## KiCad design hardware/esp-sensor/modules/AIR-CO2/AIR-CO2.kicad_pcb (2026-08-07)

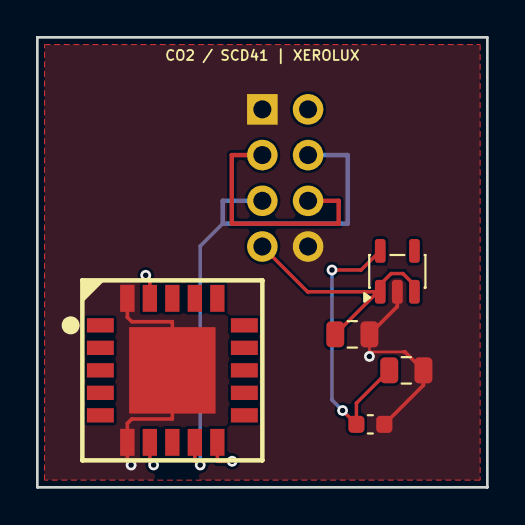
[picture p34: board AIR-CO2.kicad_pcb from above]

Board: 4 copper layers, 25.0 x 25.0 mm, 6 parts (1 on the bottom side), 5 nets.

Parts:
C1: 10u; C_0805_2012Metric
C2: 22u; C_0805_2012Metric
C3: 100n; C_0603_1608Metric
J1: AIR-SLOT; PinSocket_2x04_P2.54mm_Vertical
U1: SCD41-D-R1; SENSOR-SMD_SCD41-D-R1
U2: AP2112K-3.3; SOT-23-5

Connections:
GND: C1.2, C2.2, C3.2, J1.1, J1.8, U1.6, U1.20, U1.21, U2.2
I2C_SCL: J1.4, J1.5, U1.9
I2C_SDA: J1.3, J1.6, U1.10
MOD_3V3: C2.1, C3.1, U1.7, U1.19, U2.5
SLOT_5V: C1.1, J1.2, J1.7, U2.1, U2.3
