Xerolux/IDM-Smart-Climate-Platform/hardware/esp-sensor/modules/AIR-VOCNOX/AIR-VOCNOX.kicad_pcb

## KiCad design hardware/esp-sensor/modules/AIR-VOCNOX/AIR-VOCNOX.kicad_pcb (2026-08-07)

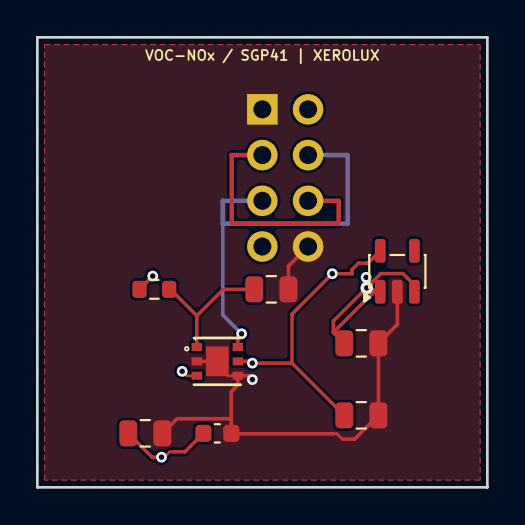
[picture p35: board AIR-VOCNOX.kicad_pcb from above]

Board: 4 copper layers, 25.0 x 25.0 mm, 9 parts (1 on the bottom side), 6 nets.

Parts:
C1, C2: 1u; C_0805_2012Metric
C3: 100n; C_0603_1608Metric
C4: 10u; C_0805_2012Metric
C5: 22u; C_0805_2012Metric
J1: AIR-SLOT; PinSocket_2x04_P2.54mm_Vertical
R1: 10R; R_0603_1608Metric
U1: SGP41-D-R4; DFN-6_L2.4-W2.4-P0.80-TL-EP
U2: AP2112K-3.3; SOT-23-5

Connections:
GND: C1.2, C2.2, C3.2, C4.2, C5.2, J1.1, J1.8, U1.2, U1.4, U1.7, U2.2
I2C_SCL: J1.4, J1.5, U1.6
I2C_SDA: J1.3, J1.6, U1.3
MOD_3V3: C2.1, C3.1, C5.1, R1.1, U1.5, U2.5
SGP_VDD: C1.1, R1.2, U1.1
SLOT_5V: C4.1, J1.2, J1.7, U2.1, U2.3
