Xerolux/IDM-Smart-Climate-Platform/hardware/esp-sensor/modules/AIR-PRESSURE/AIR-PRESSURE.kicad_pcb

## KiCad design hardware/esp-sensor/modules/AIR-PRESSURE/AIR-PRESSURE.kicad_pcb (2026-08-07)

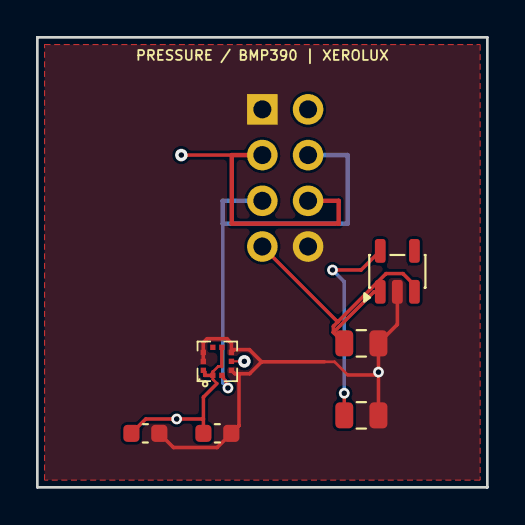
[picture p36: board AIR-PRESSURE.kicad_pcb from above]

Board: 4 copper layers, 25.0 x 25.0 mm, 7 parts (1 on the bottom side), 5 nets.

Parts:
C1, C2: 100n; C_0603_1608Metric
C3: 10u; C_0805_2012Metric
C4: 22u; C_0805_2012Metric
J1: AIR-SLOT; PinSocket_2x04_P2.54mm_Vertical
U1: BMP390; LGA-10_L2.0-W2.0-P0.50-BL
U2: AP2112K-3.3; SOT-23-5

Connections:
GND: C1.2, C2.2, C3.2, C4.2, J1.1, J1.8, U1.3, U1.5, U1.8, U1.9, U2.2
I2C_SCL: J1.4, J1.5, U1.2
I2C_SDA: J1.3, J1.6, U1.4
MOD_3V3: C1.1, C2.1, C4.1, U1.1, U1.6, U1.10, U2.5
SLOT_5V: C3.1, J1.2, J1.7, U2.1, U2.3
