Xerolux/IDM-Smart-Climate-Platform/hardware/fake-sensor/IDM-FakeSensor-ESP-B-ES1.kicad_pcb

## KiCad design hardware/fake-sensor/IDM-FakeSensor-ESP-B-ES1.kicad_pcb (2026-08-07)

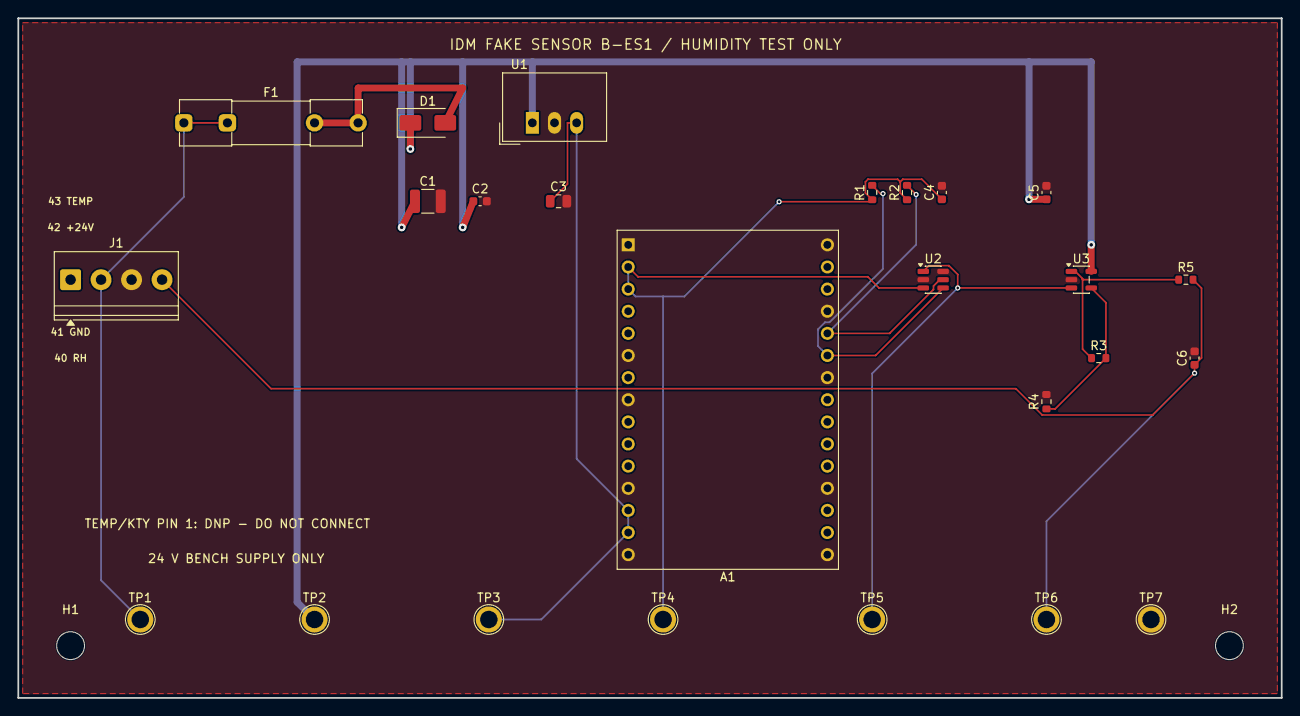
[picture p38: board IDM-FakeSensor-ESP-B-ES1.kicad_pcb from above]

Board: 2 copper layers, 145.0 x 78.0 mm, 27 parts (0 on the bottom side), 12 nets.

Parts:
A1: ESP32-C3-DevKitM-1
C1: 22u 50V; C_1210_3225Metric
C2, C5, C6: 100n 50V; C_0603_1608Metric
C3: 10u 10V; C_0805_2012Metric
C4: 100n 16V; C_0603_1608Metric
D1: SS16-E3/61T; D_SMA
F1: 500mA 5x20mm; Fuseholder_Clip-5x20mm_Littelfuse_111_Inline_P20.00x5.00mm_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
H1, H2: MountingHole_3.2mm_M3
J1: IDM / BENCH; TerminalBlock_Phoenix_PT-1,5-4-3.5-H_1x04_P3.50mm_Horizontal
R1, R2: 4.7k; R_0603_1608Metric
R3: 20.3k 0.1%; R_0603_1608Metric
R4: 10k 0.1%; R_0603_1608Metric
R5: 220R; R_0603_1608Metric
TP1: 24V_RAW; TestPoint_Plated_Hole_D2.0mm
TP2: 24V_PROT; TestPoint_Plated_Hole_D2.0mm
TP3: +5V; TestPoint_Plated_Hole_D2.0mm
TP4: +3V3; TestPoint_Plated_Hole_D2.0mm
TP5: DAC_RAW; TestPoint_Plated_Hole_D2.0mm
TP6: RH_OUT; TestPoint_Plated_Hole_D2.0mm
TP7: GND; TestPoint_Plated_Hole_D2.0mm
U1: TSR 1-2450; Converter_DCDC_TRACO_TSR-1_THT
U2: MCP4725A0T-E/CH; SOT-23-6
U3: OPA197IDBVR; SOT-23-5

Connections:
24V_FUSED: D1.2, F1.2
24V_PROT: C1.1, C2.1, C5.1, D1.1, TP2.1, U1.1, U3.5
24V_RAW: F1.1, J1.2, TP1.1
+3V3: A1.2, A1.3, C4.1, R1.1, R2.1, TP4.1, U2.3
+5V: A1.13, A1.14, C3.1, TP3.1, U1.3
DAC_RAW: TP5.1, U2.1, U3.3
GND: A1.1, A1.6, A1.8, A1.12, A1.15, A1.16, A1.19, A1.24, A1.27, A1.30, C1.2, C2.2, C3.2, C4.2, C5.2, C6.2, J1.3, R4.2, TP7.1, U1.2, U2.2, U2.6, U3.2
I2C_SCL: A1.26, R2.2, U2.5
I2C_SDA: A1.25, R1.2, U2.4
OPAMP_FB: R3.2, R4.1, U3.4
OPAMP_OUT: R3.1, R5.1, U3.1
RH_OUT: C6.1, J1.4, R5.2, TP6.1
