Xerolux/IDM-Smart-Climate-Platform/(commit log)

2026-08-07 feat(hardware): release three B-ES1 PCB packages
    [B-ES1-BOM.csv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]
2026-08-07 feat(hardware): add JLCPCB ESP assembly package
    [HAND_ASSEMBLY.csv, JLCPCB_BOM.csv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]
2026-08-07 feat(hardware): add ESP32-C6 B-ES2 order package
    [B-ES2-C6-BOM.csv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]
2026-08-07 fix(hardware): use neutral B-ES2-C6 silkscreen branding
    [IDM-RoomSensor-ESP-B-ES2-C6-B_Cu.gbl, IDM-RoomSensor-ESP-B-ES2-C6-B_Mask.gbs, IDM-RoomSensor-ESP-B-ES2-C6-B_Silkscreen.gbo, IDM-RoomSensor-ESP-B-ES2-C6-Edge_Cuts.gm1, IDM-RoomSensor-ESP-B-ES2-C6-F_Cu.gtl, IDM-RoomSensor-ESP-B-ES2-C6-F_Mask.gts, IDM-RoomSensor-ESP-B-ES2-C6-F_Silkscreen.gto, IDM-RoomSensor-ESP-B-ES2-C6-NPTH.drl]
2026-08-07 fix(hardware): correct C6 JLCPCB part mappings
    [B-ES2-C6-BOM.csv, IDM-RoomSensor-ESP-B-ES2-C6-positions.csv, IDM-RoomSensor-ESP-B-ES2-C6.kicad_pcb, IDM-RoomSensor-ESP-B-ES2-C6.kicad_sch, JLCPCB_BOM.csv]
2026-08-07 fix(hardware): reduce isolated RS485 assembly cost
    [B-ES2-C6-BOM.csv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]
2026-08-07 docs(hardware): define field-ready 1-Wire revision
2026-08-07 feat(hardware): add B-ES3 push-in field interfaces
    [B-ES3-C6-BOM.csv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]
2026-08-07 feat(hardware): add printable B-ES3 enclosure
    [idm-roomsensor-b-es3-c6-enclosure.scad, idm-roomsensor-b-es3-c6_base.stl, idm-roomsensor-b-es3-c6_lid.stl]
2026-08-07 feat(hardware): prepare B-ES3 enclosure for Ultimaker S5
    [idm-roomsensor-b-es3-c6-enclosure.scad, idm-roomsensor-b-es3-c6_S5-print-plate.stl, idm-roomsensor-b-es3-c6_base.stl, idm-roomsensor-b-es3-c6_lid.stl]
2026-08-07 feat(hardware): publish complete B-ES3 build package
    [B-ES3-C6-MECHANIK-BOM.csv]
2026-08-07 feat(hardware): publish B-ES4-AIR ultimate package
    [B-ES4-AIR-BOM.csv, B-ES4-AIR-MECHANIK-BOM.csv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]
2026-08-07 Add B-ES5 modular air sensor platform
    [AIR-CO2-BOM.csv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]
2026-08-08 Add B-ES4 Ultimate R2 power and relay revision
    [B-ES4-AIR-R2-BOM.csv, B-ES4-AIR-R2-MECHANIK-BOM.csv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]
2026-08-08 Refresh B-ES4 R2 BOM for JLCPCB stock
    [B-ES4-AIR-R2-BOM.csv, JLCPCB_BOM.csv]
2026-08-08 Replace unavailable B-ES4 R2 terminals
    [B-ES4-AIR-R2-BOM.csv, IDM-RoomSensor-ESP-B-ES4-AIR-R2.kicad_sch, JLCPCB_BOM.csv]
2026-08-08 Use stocked ESP32-C6 N8 and BMP388 for B-ES4 R2
    [B-ES4-AIR-R2-BOM.csv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]
2026-08-19 Archive recovered B-SS2, B-SU1 PoE and B-ES3-C6 hardware
    [BOM.csv, MECHANIK-BOM.csv]
